PUT-Motorsport/PUTM_EV_AMS_MASTER/documentation/vscode/data/molicelP50B/data/molicelP50B/soc_ocv_curves.png

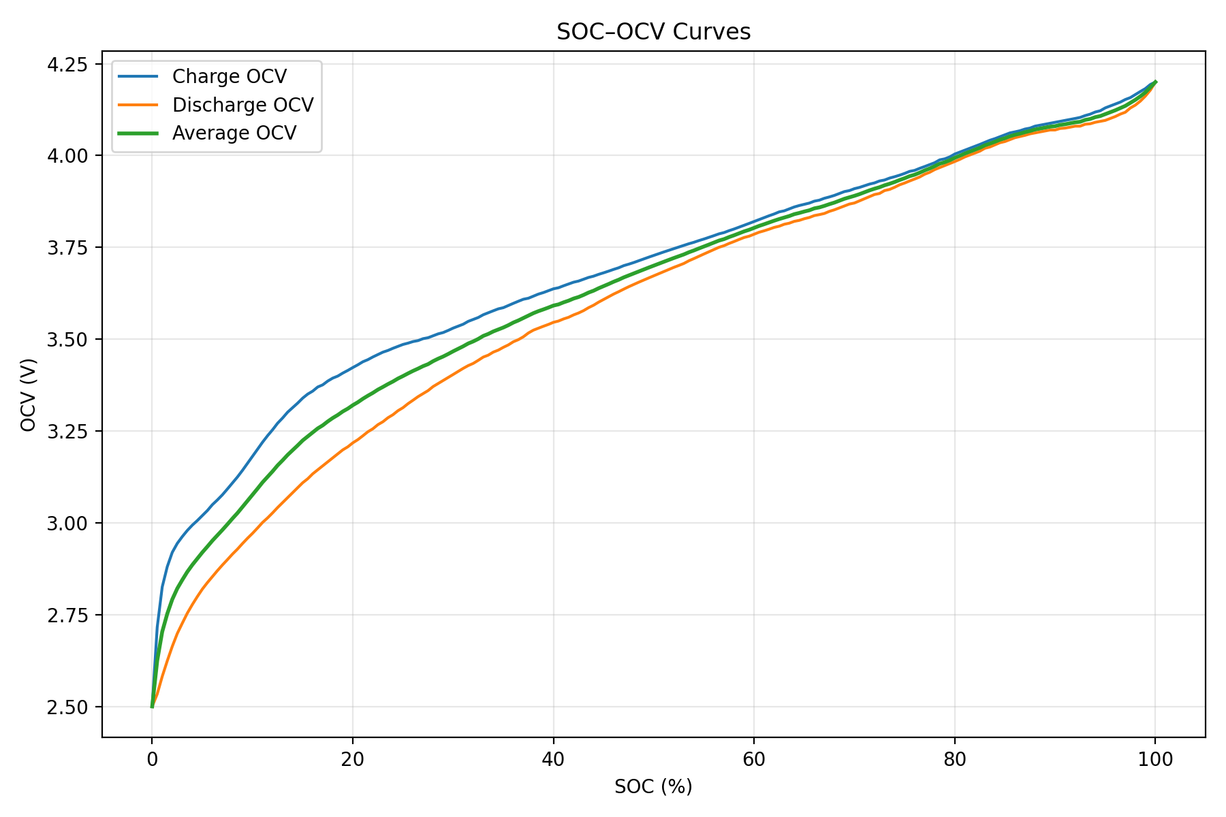
documentation/vscode/data/molicelP50B/data/molicelP50B/soc_ocv_curves.png
