PUT-Motorsport/PUTM_EV_AMS_MASTER/documentation/vscode/python/batemoP50-25C-DCR.png

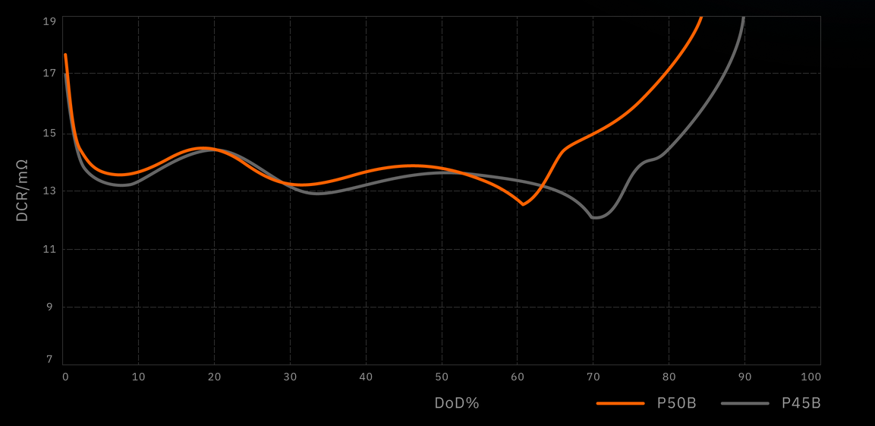
documentation/vscode/python/batemoP50-25C-DCR.png
