PUT-Motorsport/PUTM_EV_AMS_MASTER/documentation/vscode/python/batemoP50-60-DCR.png

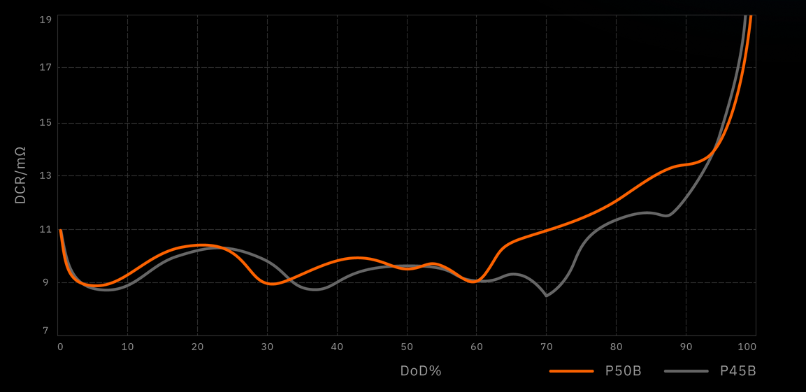
documentation/vscode/python/batemoP50-60-DCR.png
