PUT-Motorsport/PUTM_EV_AMS_MASTER/hardware/AirControl.kicad_sch

## KiCad design hardware/AirControl.kicad_sch (2025-06-25)

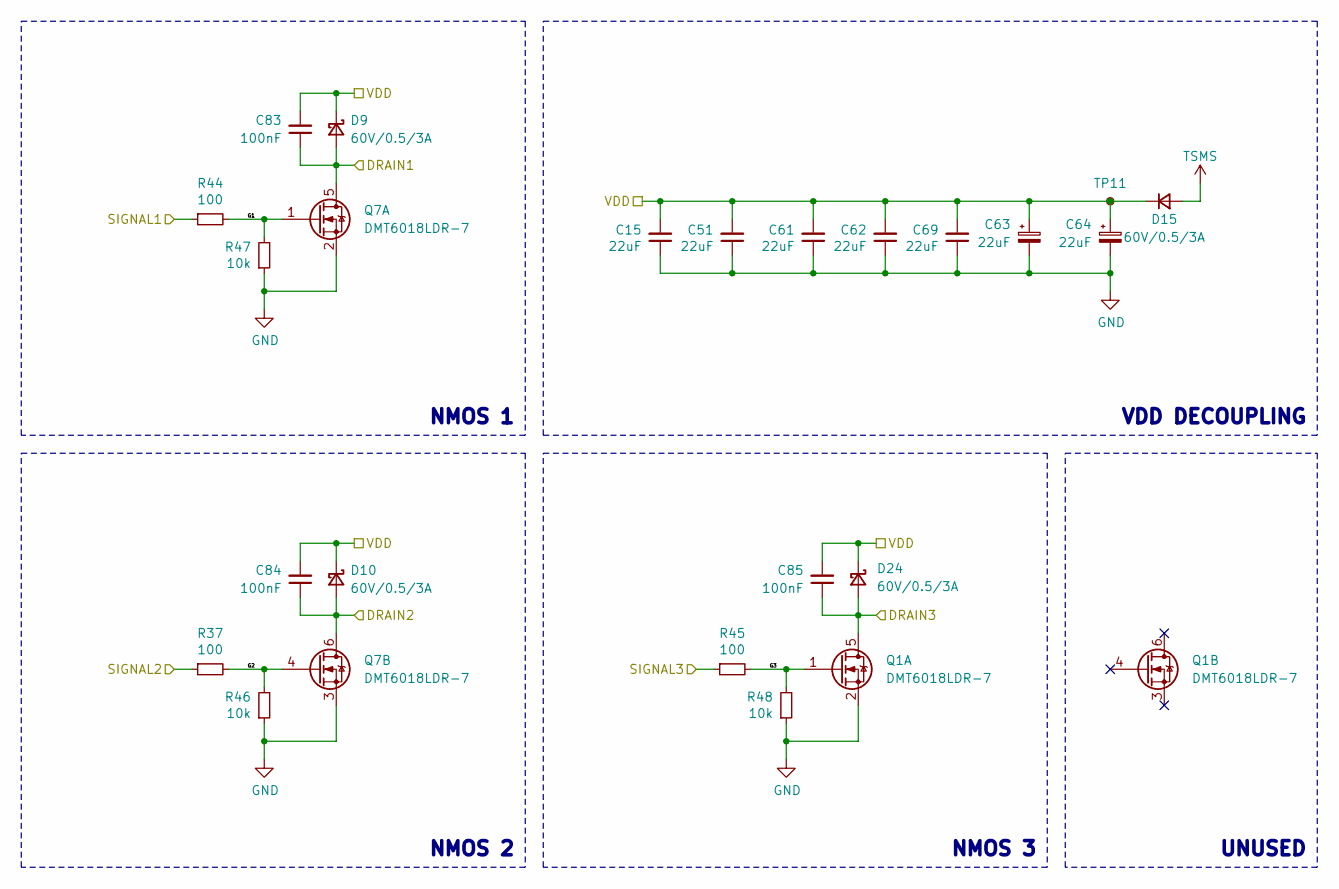
[picture p6: schematic AirControl.kicad_sch]

Parts:
C15, C51, C61, C62, C69: 22uF; C_0805_2012Metric; Manufacturer_Part_Number CL21A107MQYNNWE; Mouser Part Number 810-C2012X5R1V226MAC
C63, C64: 22uF; CP_Elec_4x5.8; Mouser Part Number 647-UCM1V220MCL1GS
C83, C84, C85: 100nF; C_0603_1608Metric; Manufacturer_Part_Number --; Mouser Part Number --
D9, D10, D15, D24: 60V/0.5/3A; D_SOD-123; Mouser Part Number 637-SKL36
Q1, Q7: DMT6018LDR-7; DMT6018LDR7; Mouser Part Number 621-DMT6018LDR-7
R37, R44, R45: 100; R_0603_1608Metric; Manufacturer_Part_Number --; Mouser Part Number --
R46, R47, R48: 10k; R_0603_1608Metric; Manufacturer_Part_Number --; Mouser Part Number --
TP11: TestPoint_Small; TestPoint_THTPad_D1.0mm_Drill0.5mm; Mouser Part Number --

Connections:
DRAIN1: C83.1, D9.2 (A), Q7.5 (D1)
DRAIN2: C84.1, D10.2 (A), Q7.6 (D2)
DRAIN3: C85.1, D24.2 (A), Q1.5 (D1)
G1: Q7.1 (G1), R44.2, R47.2
G2: Q7.4 (G2), R37.2, R46.2
G3: Q1.1 (G1), R45.2, R48.2
GND: C15.1, C51.1, C61.1, C62.1, C63.2, C64.2, C69.1, Q1.2 (S1), Q7.2 (S1), Q7.3 (S2), R46.1, R47.1, R48.1
SIGNAL1: R44.1
SIGNAL2: R37.1
SIGNAL3: R45.1
TSMS: D15.2 (A)
VDD: C15.2, C51.2, C61.2, C62.2, C63.1, C64.1, C69.2, C83.2, C84.2, C85.2, D9.1 (K), D10.1 (K), D15.1 (K), D24.1 (K), TP11.1

Notes on the sheet:
UNUSED
NMOS 1
VDD DECOUPLING
NMOS 2
NMOS 3
