PUT-Motorsport/PUTM_EV_AMS_MASTER/hardware/Connectivity.kicad_sch

## KiCad design hardware/Connectivity.kicad_sch (2025-06-25)

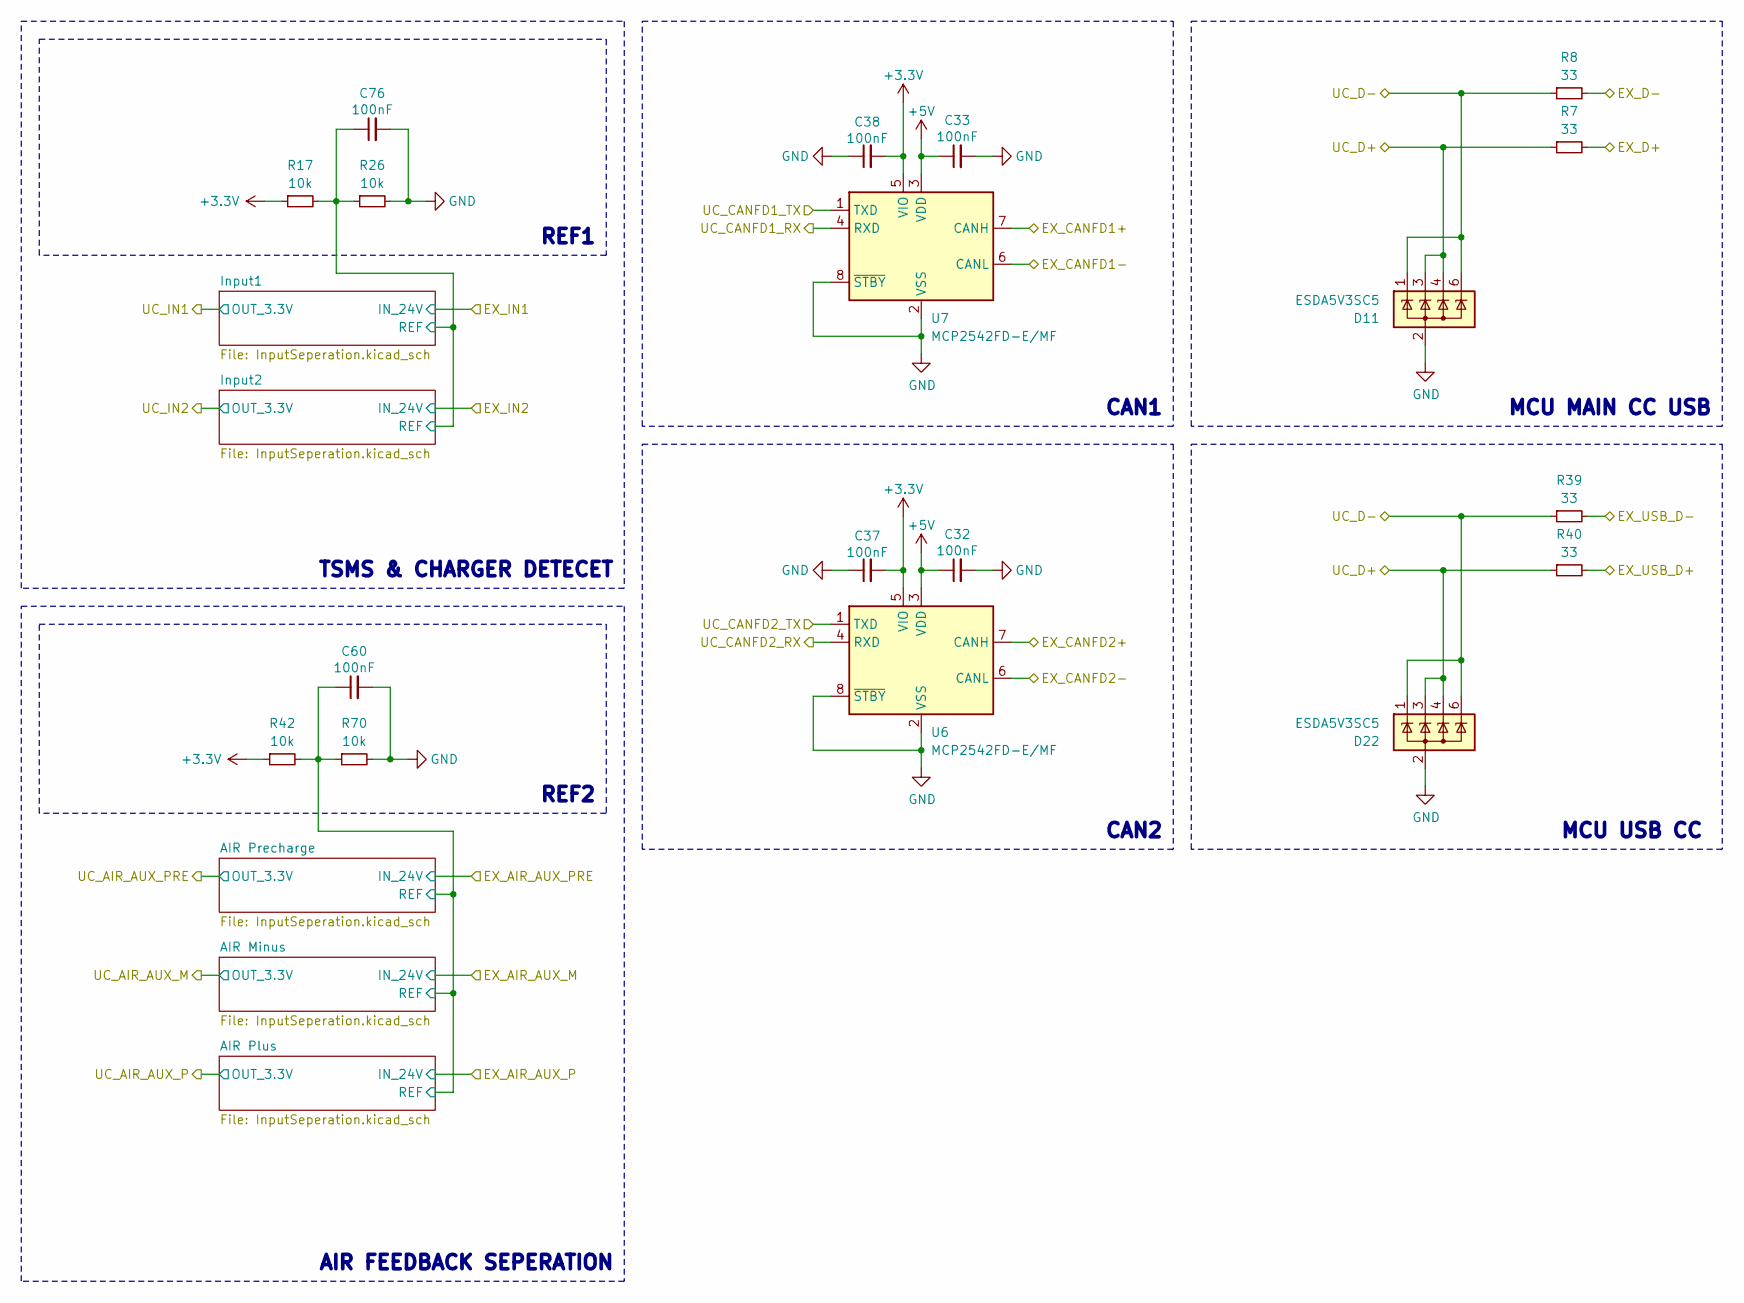
[picture p7: schematic Connectivity.kicad_sch]

Parts:
C32, C33, C37, C38, C60, C76: 100nF; C_0603_1608Metric; Manufacturer_Part_Number --; Mouser Part Number --
D11, D22: ESDA5V3SC5; SOT-23-6; Manufacturer_Part_Number ESDA5V3SC5; Mouser Part Number 511-ESDA5V3SC5
R7, R8, R39, R40: 33; R_0603_1608Metric; Manufacturer_Part_Number --; Mouser Part Number 71-CRCW060333R0FKEC
R17, R26, R42, R70: 10k; R_0603_1608Metric; Manufacturer_Part_Number --; Mouser Part Number --
U6, U7: MCP2542FD-E/MF; DFN-8-1EP_3x3mm_P0.65mm_EP1.55x2.4mm; Manufacturer_Part_Number MCP2542FD-E/MF; Mouser Part Number 579-MCP2542FD-E/MF

Connections:
+3.3V: C37.2, C38.2, R17.1, R42.1, U6.5 (VIO), U7.5 (VIO)
+5V: C32.1, C33.1, U6.3 (VDD), U7.3 (VDD)
EX_CANFD1+: U7.7 (CANH)
EX_CANFD1-: U7.6 (CANL)
EX_CANFD2+: U6.7 (CANH)
EX_CANFD2-: U6.6 (CANL)
EX_D+: R7.2
EX_D-: R8.2
EX_USB_D+: R40.2
EX_USB_D-: R39.2
GND: C32.2, C33.2, C37.1, C38.1, C60.2, C76.2, D11.2 (K), D11.5 (NC), D22.2 (K), D22.5 (NC), R26.2, R70.2, U6.2 (VSS), U6.8 (~STBY), U6.9 (VSS), U7.2 (VSS), U7.8 (~STBY), U7.9 (VSS)
REF: C60.1, C76.1, R17.2, R26.1, R42.2, R70.1
UC_CANFD1_RX: U7.4 (RXD)
UC_CANFD1_TX: U7.1 (TXD)
UC_CANFD2_RX: U6.4 (RXD)
UC_CANFD2_TX: U6.1 (TXD)
UC_D+: D11.3 (A), D11.4 (A), D22.3 (A), D22.4 (A), R7.1, R40.1
UC_D-: D11.1 (A), D11.6 (A), D22.1 (A), D22.6 (A), R8.1, R39.1

Notes on the sheet:
MCU MAIN CC USB
TSMS & CHARGER DETECET
CAN1
REF2
AIR FEEDBACK SEPERATION
REF1
CAN2
MCU USB CC
