PUT-Motorsport/PUTM_EV_AMS_MASTER/hardware/FanControl.kicad_sch

## KiCad design hardware/FanControl.kicad_sch (2025-06-25)

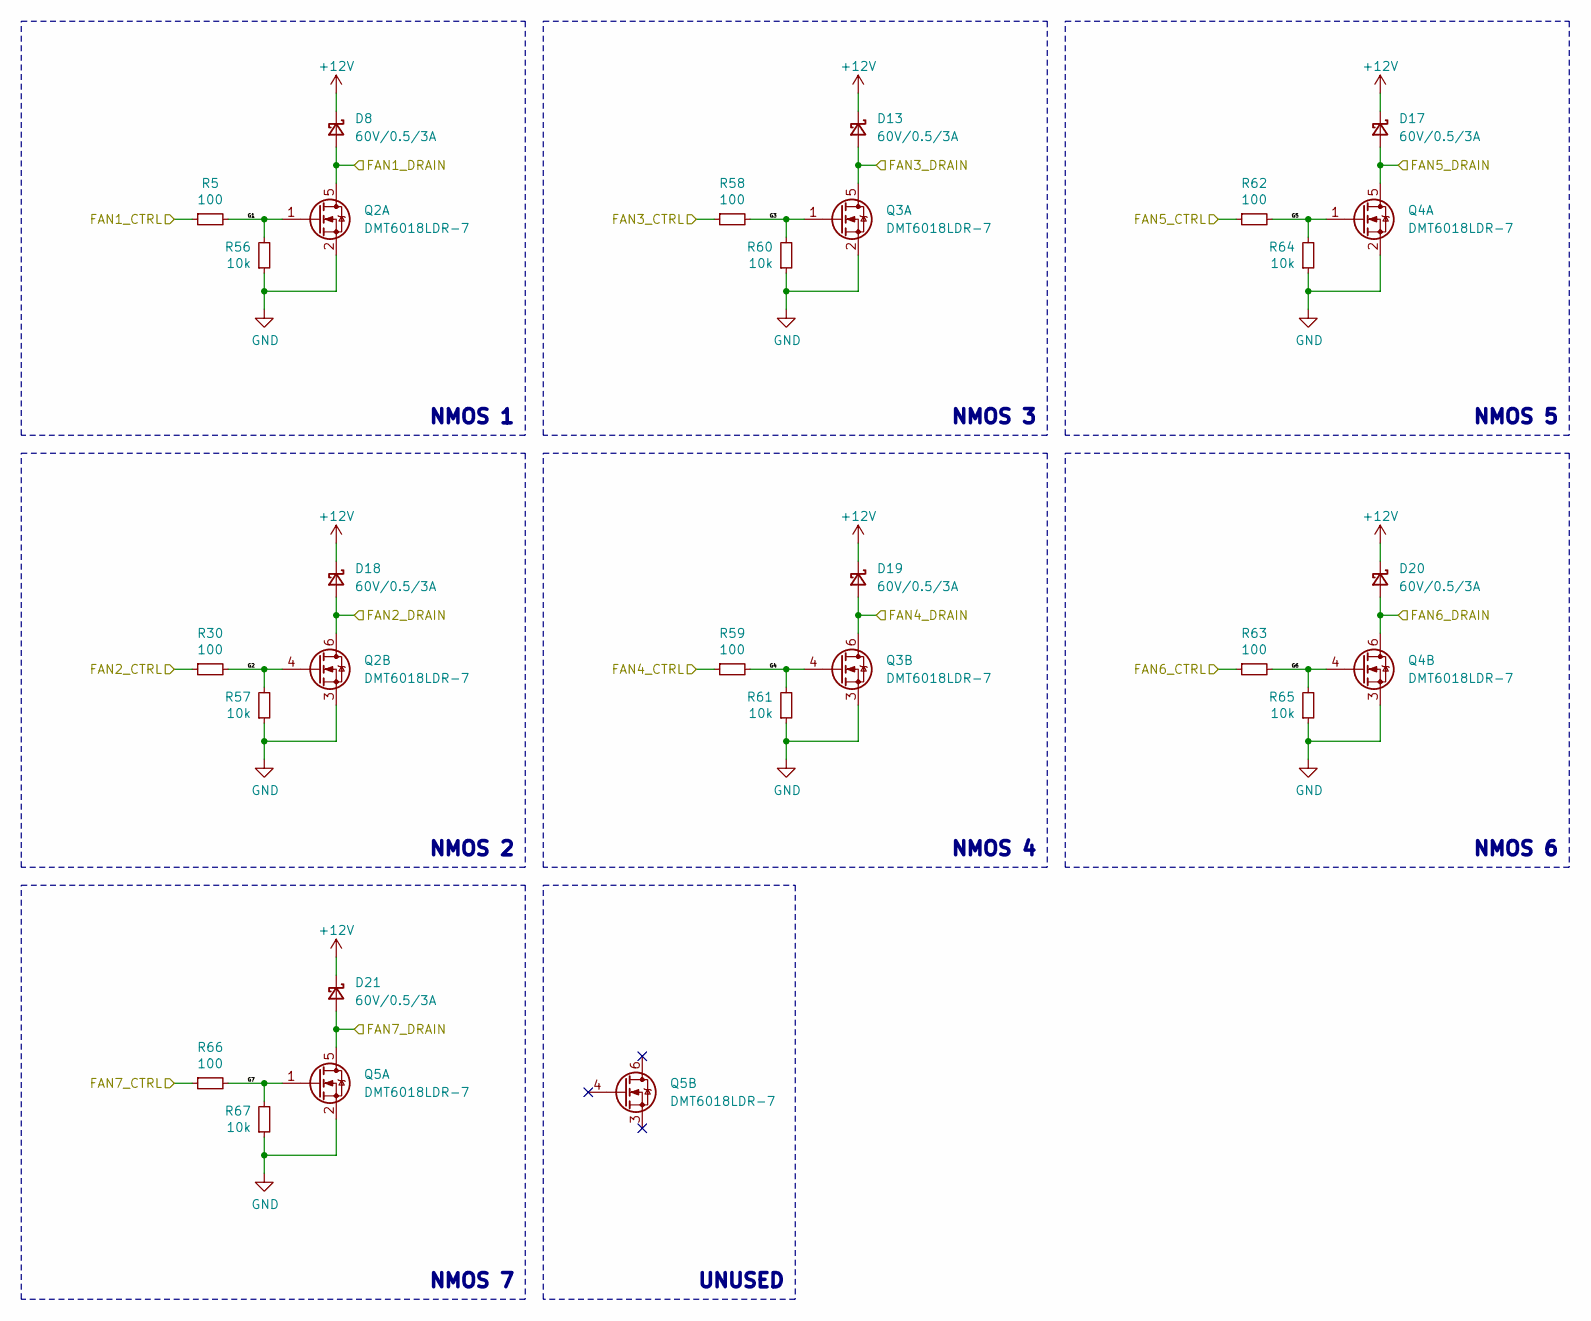
[picture p8: schematic FanControl.kicad_sch]

Parts:
D8, D13, D17, D18, D19, D20, D21: 60V/0.5/3A; D_SOD-123; Mouser Part Number 637-SKL36
Q2, Q3, Q4, Q5: DMT6018LDR-7; DMT6018LDR7; Mouser Part Number 621-DMT6018LDR-7
R5, R30, R58, R59, R62, R63, R66: 100; R_0603_1608Metric; Manufacturer_Part_Number --; Mouser Part Number --
R56, R57, R60, R61, R64, R65, R67: 10k; R_0603_1608Metric; Manufacturer_Part_Number --; Mouser Part Number --

Connections:
+12V: D8.1 (K), D13.1 (K), D17.1 (K), D18.1 (K), D19.1 (K), D20.1 (K), D21.1 (K)
FAN1_CTRL: R5.1
FAN1_DRAIN: D8.2 (A), Q2.5 (D1)
FAN2_CTRL: R30.1
FAN2_DRAIN: D18.2 (A), Q2.6 (D2)
FAN3_CTRL: R58.1
FAN3_DRAIN: D13.2 (A), Q3.5 (D1)
FAN4_CTRL: R59.1
FAN4_DRAIN: D19.2 (A), Q3.6 (D2)
FAN5_CTRL: R62.1
FAN5_DRAIN: D17.2 (A), Q4.5 (D1)
FAN6_CTRL: R63.1
FAN6_DRAIN: D20.2 (A), Q4.6 (D2)
FAN7_CTRL: R66.1
FAN7_DRAIN: D21.2 (A), Q5.5 (D1)
G1: Q2.1 (G1), R5.2, R56.2
G2: Q2.4 (G2), R30.2, R57.2
G3: Q3.1 (G1), R58.2, R60.2
G4: Q3.4 (G2), R59.2, R61.2
G5: Q4.1 (G1), R62.2, R64.2
G6: Q4.4 (G2), R63.2, R65.2
G7: Q5.1 (G1), R66.2, R67.2
GND: Q2.2 (S1), Q2.3 (S2), Q3.2 (S1), Q3.3 (S2), Q4.2 (S1), Q4.3 (S2), Q5.2 (S1), R56.1, R57.1, R60.1, R61.1, R64.1, R65.1, R67.1

Notes on the sheet:
NMOS 2
NMOS 1
NMOS 4
UNUSED
NMOS 6
NMOS 3
NMOS 5
NMOS 7
