PUT-Motorsport/PUTM_EV_AMS_MASTER/hardware/InputSeperation.kicad_sch

## KiCad design hardware/InputSeperation.kicad_sch (2025-06-25)

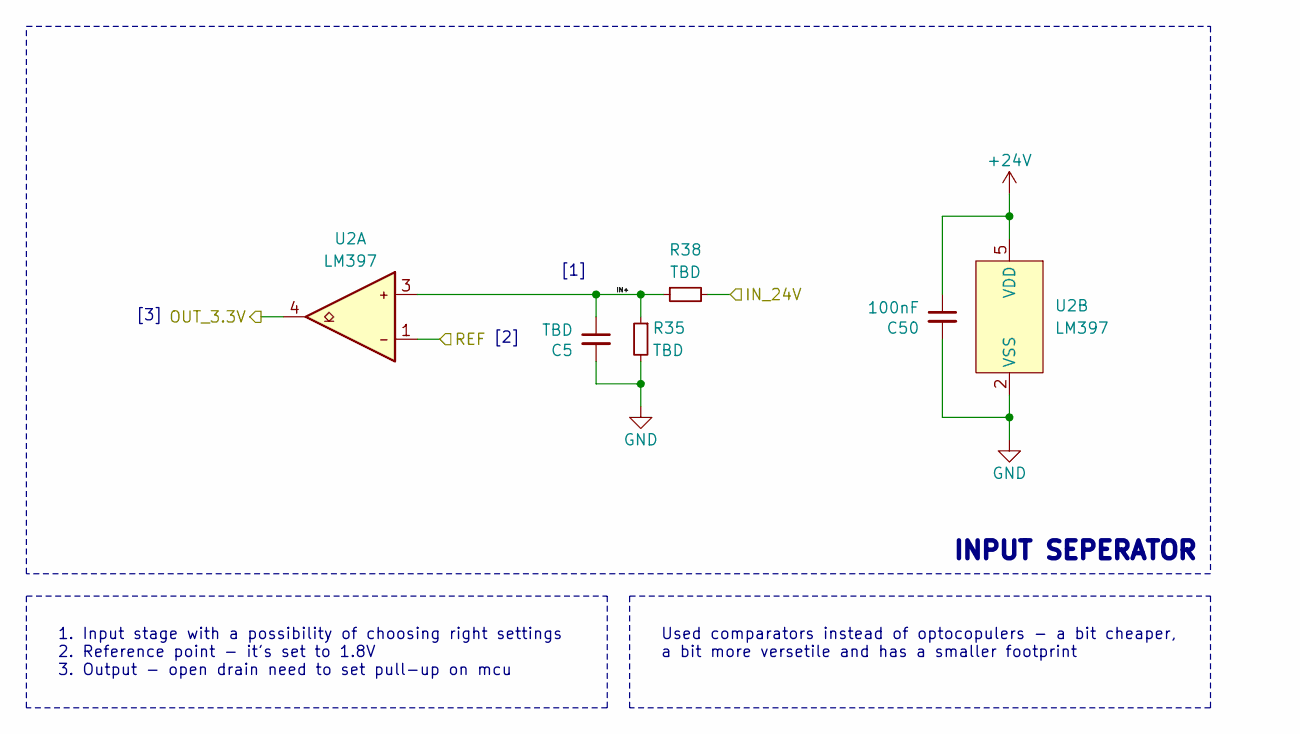
[picture p9: schematic InputSeperation.kicad_sch]

Parts:
C5: TBD; C_0603_1608Metric; Manufacturer_Part_Number --; Mouser Part Number --
C50: 100nF; C_0603_1608Metric; Manufacturer_Part_Number --; Mouser Part Number --
R35, R38: TBD; R_0603_1608Metric; Manufacturer_Part_Number --; Mouser Part Number --
U2: LM397; SOT-23-5; Manufacturer_Part_Number LM397MFX/NOPB; Mouser Part Number 926-LM397MFX/NOPB

Connections:
+24V: C50.1, U2.5 (VDD)
GND: C5.2, C50.2, R35.2, U2.2 (VSS)
IN+: C5.1, R35.1, R38.1, U2.3
IN_24V: R38.2
OUT_3.3V: U2.4
REF: U2.1

Notes on the sheet:
[2]
[3]
INPUT SEPERATOR
[1]
Used comparators instead of optocopulers - a bit cheaper, a bit more versetile and has a smaller footprint
1. Input stage with a possibility of choosing right settings 2. Reference point - it's set to 1.8V 3. Output - open drain need to set pull-up on mcu
