PUT-Motorsport/PUTM_EV_AMS_MASTER/hardware/IsolatedADC.kicad_sch

## KiCad design hardware/IsolatedADC.kicad_sch (2025-06-25)

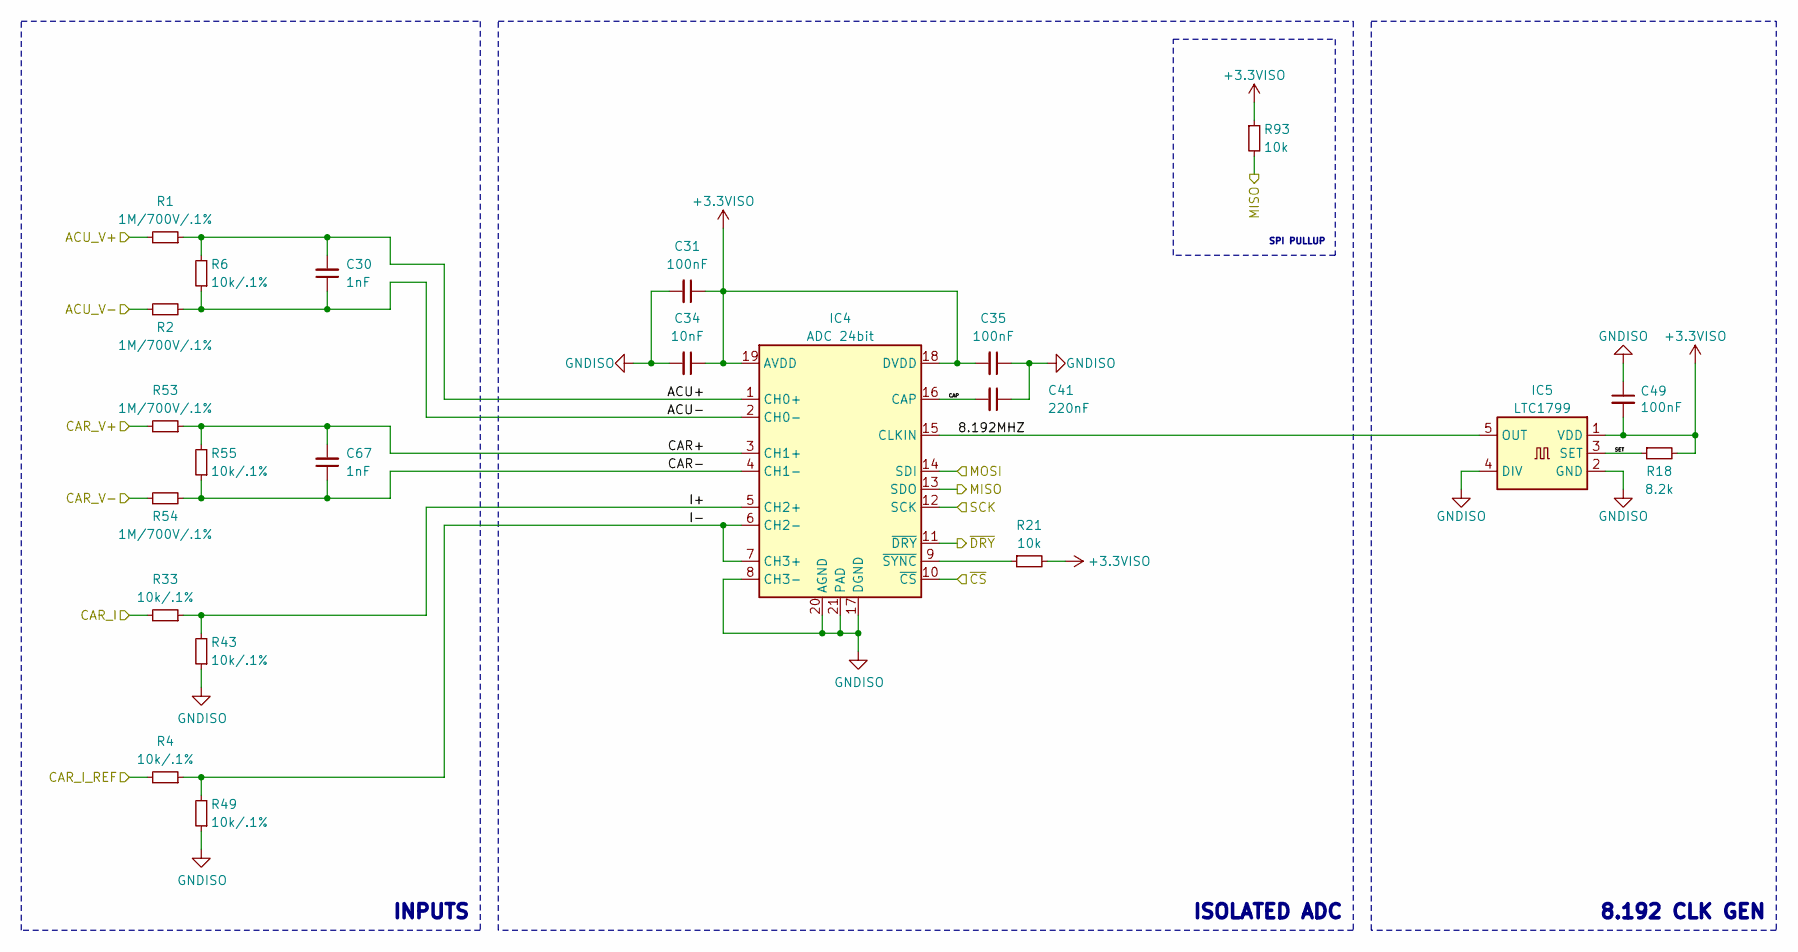
[picture p10: schematic IsolatedADC.kicad_sch]

Parts:
C30, C67: 1nF; C_0603_1608Metric; Manufacturer_Part_Number --; Mouser Part Number --
C31, C35, C49: 100nF; C_0603_1608Metric; Manufacturer_Part_Number --; Mouser Part Number --
C34: 10nF; C_0603_1608Metric; Manufacturer_Part_Number --; Mouser Part Number --
C41: 220nF; C_0603_1608Metric; Manufacturer_Part_Number --; Mouser Part Number 963-H168SC7224KTCA1J
IC4: ADC 24bit; WQFN-20-1EP_3x3mm_P0.4mm_EP1.7x1.7mm; Mouser Part Number 595-ADS131M04IRUKR
IC5: LTC1799; SOT-23-5; Mouser Part Number 584-LTC1799CS5#TRPBF
R1, R2, R53, R54: 1M/700V/.1%; R_1206_3216Metric; Manufacturer_Part_Number 754-RGV3216P-1004BT1; Mouser Part Number 754-RGV3216P-1004BT1
R4, R33: 10k/.1%; R_0603_1608Metric; Manufacturer_Part_Number --; Mouser Part Number --
R6, R43, R49, R55: 10k/.1%; R_1206_3216Metric; Manufacturer_Part_Number --; Mouser Part Number 708-RNCF1206BKE100R
R18: 8.2k; R_0603_1608Metric; Manufacturer_Part_Number --; Mouser Part Number 603-RT0603FRD078K2L
R21, R93: 10k; R_0603_1608Metric; Manufacturer_Part_Number --; Mouser Part Number --

Connections:
8.192MHZ: IC4.15 (CLKIN), IC5.5 (OUT)
+3.3VISO: C31.1, C34.1, C35.2, C49.2, IC4.18 (DVDD), IC4.19 (AVDD), IC5.1 (VDD), R18.2, R21.2, R93.1
ACU+: C30.2, IC4.1 (CH0+), R1.1, R6.2
ACU-: C30.1, IC4.2 (CH0-), R2.2, R6.1
ACU_V+: R1.2
ACU_V-: R2.1
CAP: C41.2, IC4.16 (CAP)
CAR+: C67.2, IC4.3 (CH1+), R53.1, R55.2
CAR-: C67.1, IC4.4 (CH1-), R54.2, R55.1
CAR_I: R33.2
CAR_I_REF: R4.2
CAR_V+: R53.2
CAR_V-: R54.1
GNDISO: C31.2, C34.2, C35.1, C41.1, C49.1, IC4.8 (CH3-), IC4.17 (DGND), IC4.20 (AGND), IC4.21 (PAD), IC5.2 (GND), IC5.4 (DIV), R43.1, R49.1
I+: IC4.5 (CH2+), R33.1, R43.2
I-: IC4.6 (CH2-), IC4.7 (CH3+), R4.1, R49.2
MISO: IC4.13 (SDO), R93.2
MOSI: IC4.14 (SDI)
unnamed: IC4.9 (~SYNC), R21.1
SCK: IC4.12 (SCK)
SET: IC5.3 (SET), R18.1
~CS: IC4.10 (~CS)
~DRY: IC4.11 (~DRY)

Notes on the sheet:
SPI PULLUP
INPUTS
8.192 CLK GEN
ISOLATED ADC
