PUT-Motorsport/PUTM_EV_AMS_MASTER/hardware/IsolatedSPI.kicad_sch

## KiCad design hardware/IsolatedSPI.kicad_sch (2025-06-25)

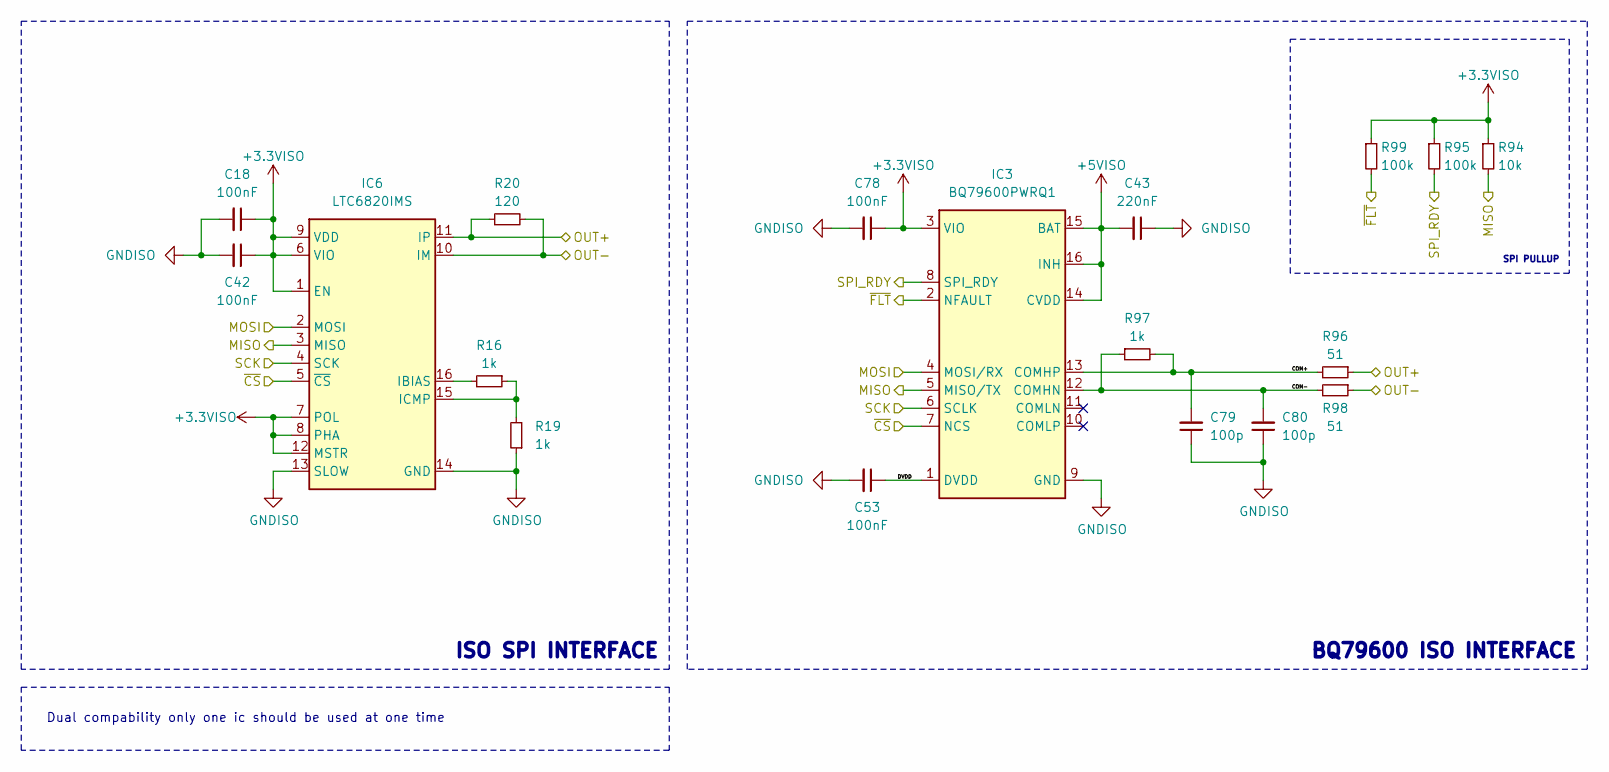
[picture p11: schematic IsolatedSPI.kicad_sch]

Parts:
C18, C42, C53, C78: 100nF; C_0603_1608Metric; Manufacturer_Part_Number --; Mouser Part Number --
C43: 220nF; C_0603_1608Metric; Manufacturer_Part_Number --; Mouser Part Number 963-H168SC7224KTCA1J
C79, C80: 100p; C_0603_1608Metric; Manufacturer_Part_Number --; Mouser Part Number 581-06035A101K
IC3: BQ79600PWRQ1; TSSOP-16_4.4x5mm_P0.65mm; Mouser Part Number 595-BQ79600PWRQ1
IC6: LTC6820IMS; MSOP-16_3x4.039mm_P0.5mm; Mouser Part Number 584-LTC6820IMS#PBF
R16, R19, R97: 1k; R_0603_1608Metric; Manufacturer_Part_Number --; Mouser Part Number --
R20: 120; R_0603_1608Metric; Manufacturer_Part_Number --; Mouser Part Number --
R94: 10k; R_0603_1608Metric; Manufacturer_Part_Number --; Mouser Part Number --
R95, R99: 100k; R_0603_1608Metric; Manufacturer_Part_Number --; Mouser Part Number --
R96, R98: 51; R_0603_1608Metric; Manufacturer_Part_Number --; Mouser Part Number 594-MCT06030C5109FP5

Connections:
+3.3VISO: C18.1, C42.1, C78.1, IC3.3 (VIO), IC6.1 (EN), IC6.6 (VIO), IC6.7 (POL), IC6.8 (PHA), IC6.9 (VDD), IC6.12 (MSTR), R94.1, R95.1, R99.1
+5VISO: C43.2, IC3.14 (CVDD), IC3.15 (BAT), IC3.16 (INH)
COM+: C79.2, IC3.13 (COMHP), R96.2, R97.2
COM-: C80.2, IC3.12 (COMHN), R97.1, R98.2
DVDD: C53.1, IC3.1 (DVDD)
GNDISO: C18.2, C42.2, C43.1, C53.2, C78.2, C79.1, C80.1, IC3.9 (GND), IC6.13 (SLOW), IC6.14 (GND), R19.1
MISO: IC3.5 (MISO/TX), IC6.3 (MISO), R94.2
MOSI: IC3.4 (MOSI/RX), IC6.2 (MOSI)
unnamed: IC6.15 (ICMP), R16.1, R19.2
unnamed: IC6.16 (IBIAS), R16.2
OUT+: IC6.11 (IP), R20.1, R96.1
OUT-: IC6.10 (IM), R20.2, R98.1
SCK: IC3.6 (SCLK), IC6.4 (SCK)
SPI_RDY: IC3.8 (SPI_RDY), R95.2
~CS: IC3.7 (NCS), IC6.5 (~CS)
~FLT: IC3.2 (NFAULT), R99.2

Notes on the sheet:
ISO SPI INTERFACE
SPI PULLUP
BQ79600 ISO INTERFACE
Dual compability only one ic should be used at one time
