PUT-Motorsport/PUTM_EV_AMS_MASTER/hardware/Mcu.kicad_sch

## KiCad design hardware/Mcu.kicad_sch (2025-06-25)

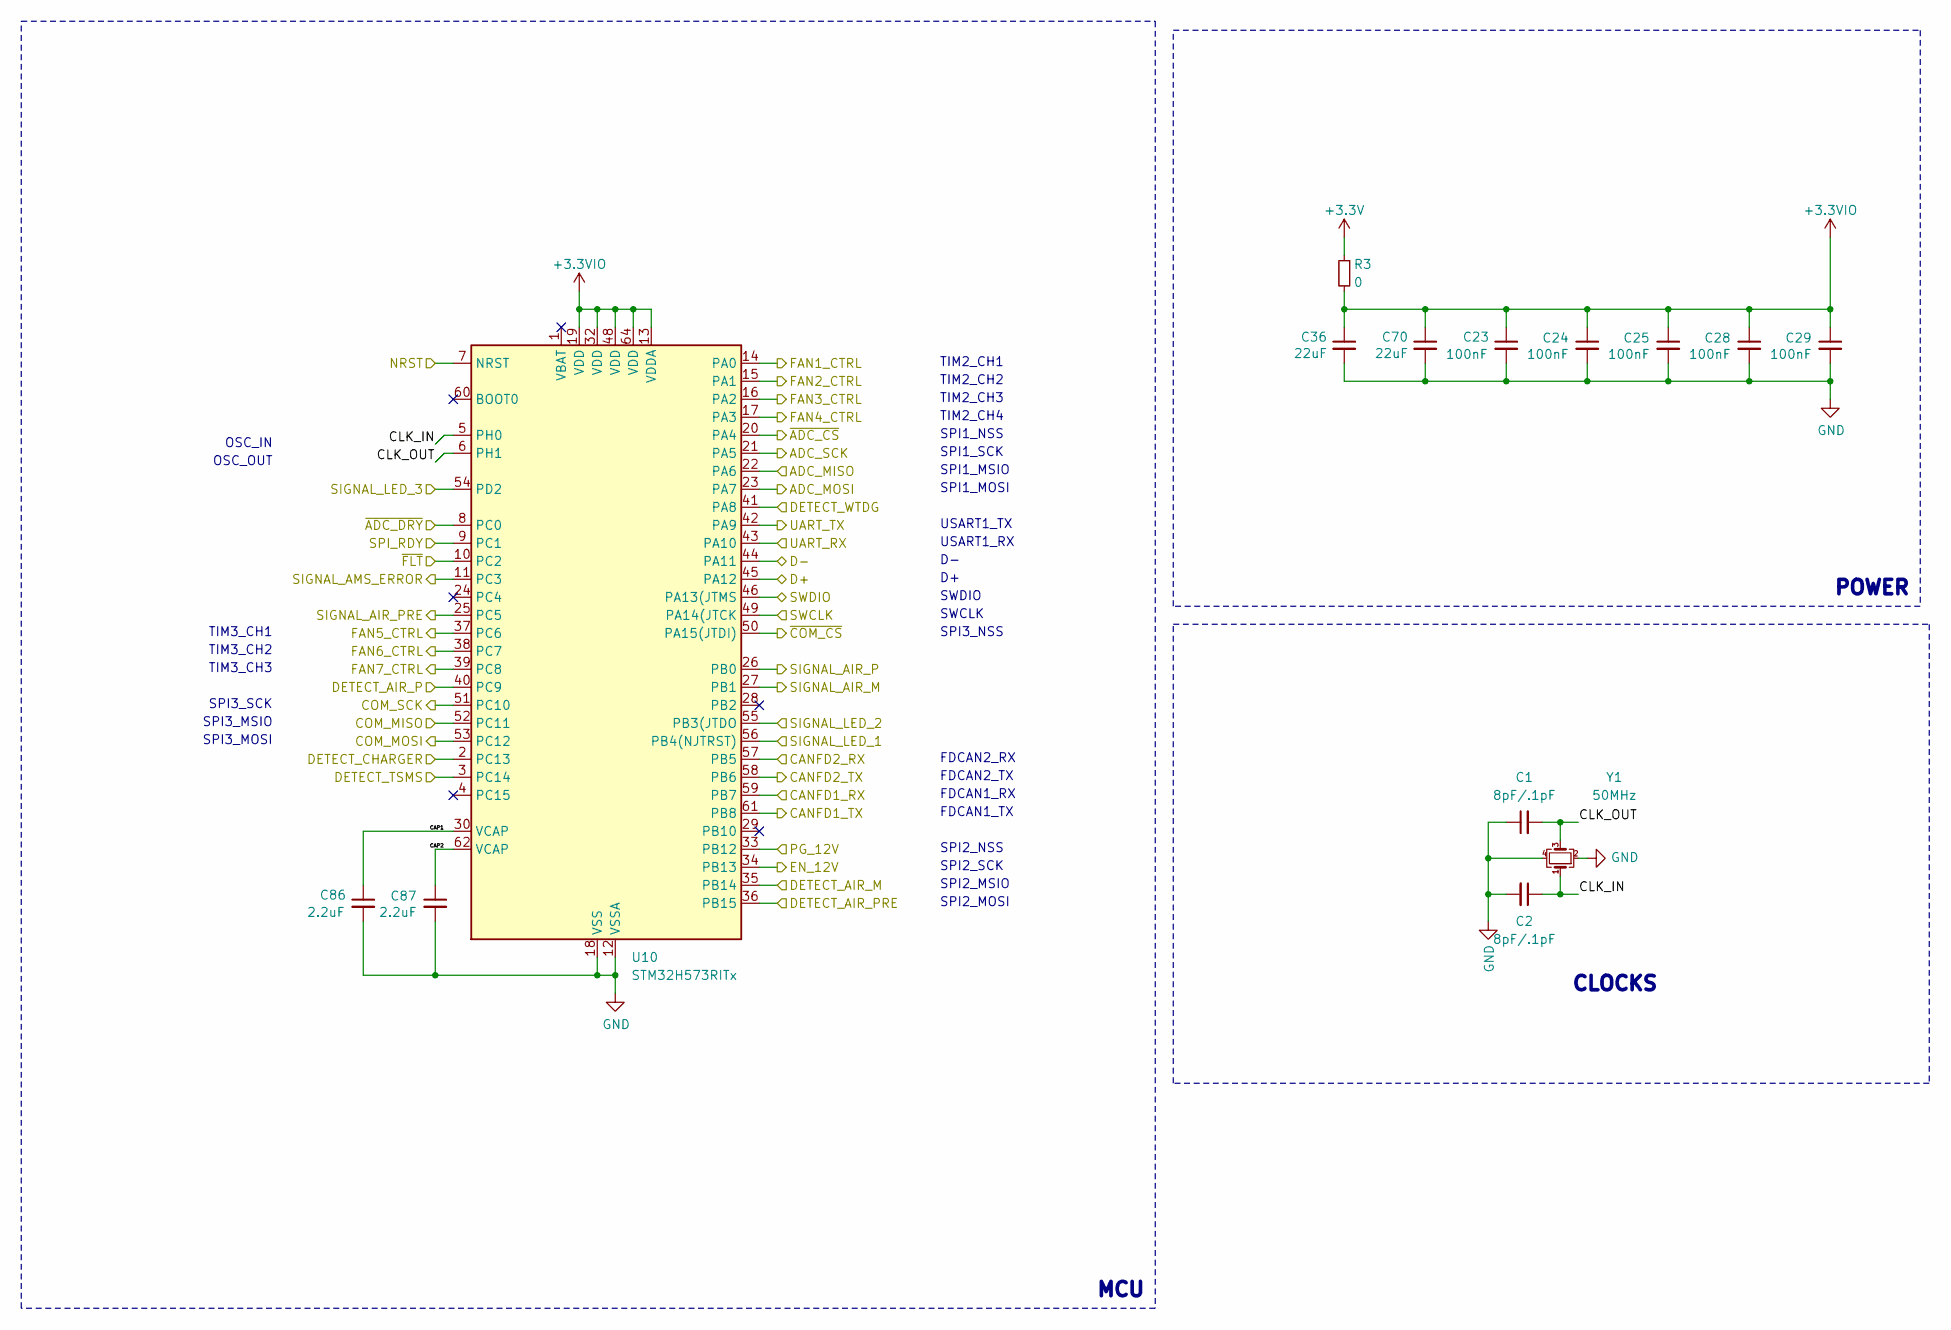
[picture p12: schematic Mcu.kicad_sch]

Parts:
C1, C2: 8pF/.1pF; C_0603_1608Metric; Manufacturer_Part_Number --; Mouser Part Number 791-RF18N8R0B500CT
C23, C24, C25, C28, C29: 100nF; C_0603_1608Metric; Manufacturer_Part_Number --; Mouser Part Number --
C36, C70: 22uF; C_0805_2012Metric; Manufacturer_Part_Number --; Mouser Part Number 810-C2012X5R1V226MAC
C86, C87: 2.2uF; C_0603_1608Metric; Manufacturer_Part_Number --; Mouser Part Number 603-CC603KPX7R9BB222
R3: 0; R_0603_1608Metric; Manufacturer_Part_Number --; Mouser Part Number --
U10: STM32H573RITx; LQFP-64_10x10mm_P0.5mm; Mouser Part Number 511-STM32H573RIT6
Y1: 50MHz; Crystal_SMD_3225-4Pin_3.2x2.5mm; Manufacturer_Part_Number --; Mouser Part Number 710-830108207809

Connections:
+3.3V: R3.1
+3.3VIO: C23.1, C24.1, C25.1, C28.1, C29.1, C36.1, C70.1, R3.2, U10.13 (VDDA), U10.19 (VDD), U10.32 (VDD), U10.48 (VDD), U10.64 (VDD)
ADC_MISO: U10.22 (PA6)
ADC_MOSI: U10.23 (PA7)
ADC_SCK: U10.21 (PA5)
CANFD1_RX: U10.59 (PB7)
CANFD1_TX: U10.61 (PB8)
CANFD2_RX: U10.57 (PB5)
CANFD2_TX: U10.58 (PB6)
CAP1: C86.1, U10.30 (VCAP)
CAP2: C87.1, U10.62 (VCAP)
CLK_IN: C2.1, U10.5 (PH0), Y1.1
CLK_OUT: C1.2, U10.6 (PH1), Y1.3
COM_MISO: U10.52 (PC11)
COM_MOSI: U10.53 (PC12)
COM_SCK: U10.51 (PC10)
D+: U10.45 (PA12)
D-: U10.44 (PA11)
DETECT_AIR_M: U10.35 (PB14)
DETECT_AIR_P: U10.40 (PC9)
DETECT_AIR_PRE: U10.36 (PB15)
DETECT_CHARGER: U10.2 (PC13)
DETECT_TSMS: U10.3 (PC14)
DETECT_WTDG: U10.41 (PA8)
EN_12V: U10.34 (PB13)
FAN1_CTRL: U10.14 (PA0)
FAN2_CTRL: U10.15 (PA1)
FAN3_CTRL: U10.16 (PA2)
FAN4_CTRL: U10.17 (PA3)
FAN5_CTRL: U10.37 (PC6)
FAN6_CTRL: U10.38 (PC7)
FAN7_CTRL: U10.39 (PC8)
GND: C1.1, C2.2, C23.2, C24.2, C25.2, C28.2, C29.2, C36.2, C70.2, C86.2, C87.2, U10.12 (VSSA), U10.18 (VSS), U10.31 (VSS), U10.47 (VSS), U10.63 (VSS), Y1.2, Y1.4
NRST: U10.7 (NRST)
PG_12V: U10.33 (PB12)
SIGNAL_AIR_M: U10.27 (PB1)
SIGNAL_AIR_P: U10.26 (PB0)
SIGNAL_AIR_PRE: U10.25 (PC5)
SIGNAL_AMS_ERROR: U10.11 (PC3)
SIGNAL_LED_1: U10.56 (PB4(NJTRST))
SIGNAL_LED_2: U10.55 (PB3(JTDO)
SIGNAL_LED_3: U10.54 (PD2)
SPI_RDY: U10.9 (PC1)
SWCLK: U10.49 (PA14(JTCK)
SWDIO: U10.46 (PA13(JTMS)
UART_RX: U10.43 (PA10)
UART_TX: U10.42 (PA9)
~ADC_CS: U10.20 (PA4)
~ADC_DRY: U10.8 (PC0)
~COM_CS: U10.50 (PA15(JTDI))
~FLT: U10.10 (PC2)

Notes on the sheet:
MCU
USART1_RX
OSC_IN
USART1_TX
TIM2_CH4
FDCAN2_TX
SPI1_MSIO
TIM2_CH2
SPI3_MOSI
SPI2_SCK
OSC_OUT
FDCAN1_TX
SPI3_MSIO
SPI3_SCK
TIM3_CH2
SPI1_SCK
TIM2_CH3
CLOCKS
SPI3_NSS
SPI1_MOSI
TIM3_CH3
SPI1_NSS
SWDIO
SPI2_MOSI
SWCLK
FDCAN2_RX
SPI2_NSS
SPI2_MSIO
TIM2_CH1
TIM3_CH1
FDCAN1_RX
POWER
