PUT-Motorsport/PUTM_EV_AMS_MASTER/hardware/PUTM_EV_AMS_MASTER_2025.kicad_sch

## KiCad design hardware/PUTM_EV_AMS_MASTER_2025.kicad_sch (2025-06-25)

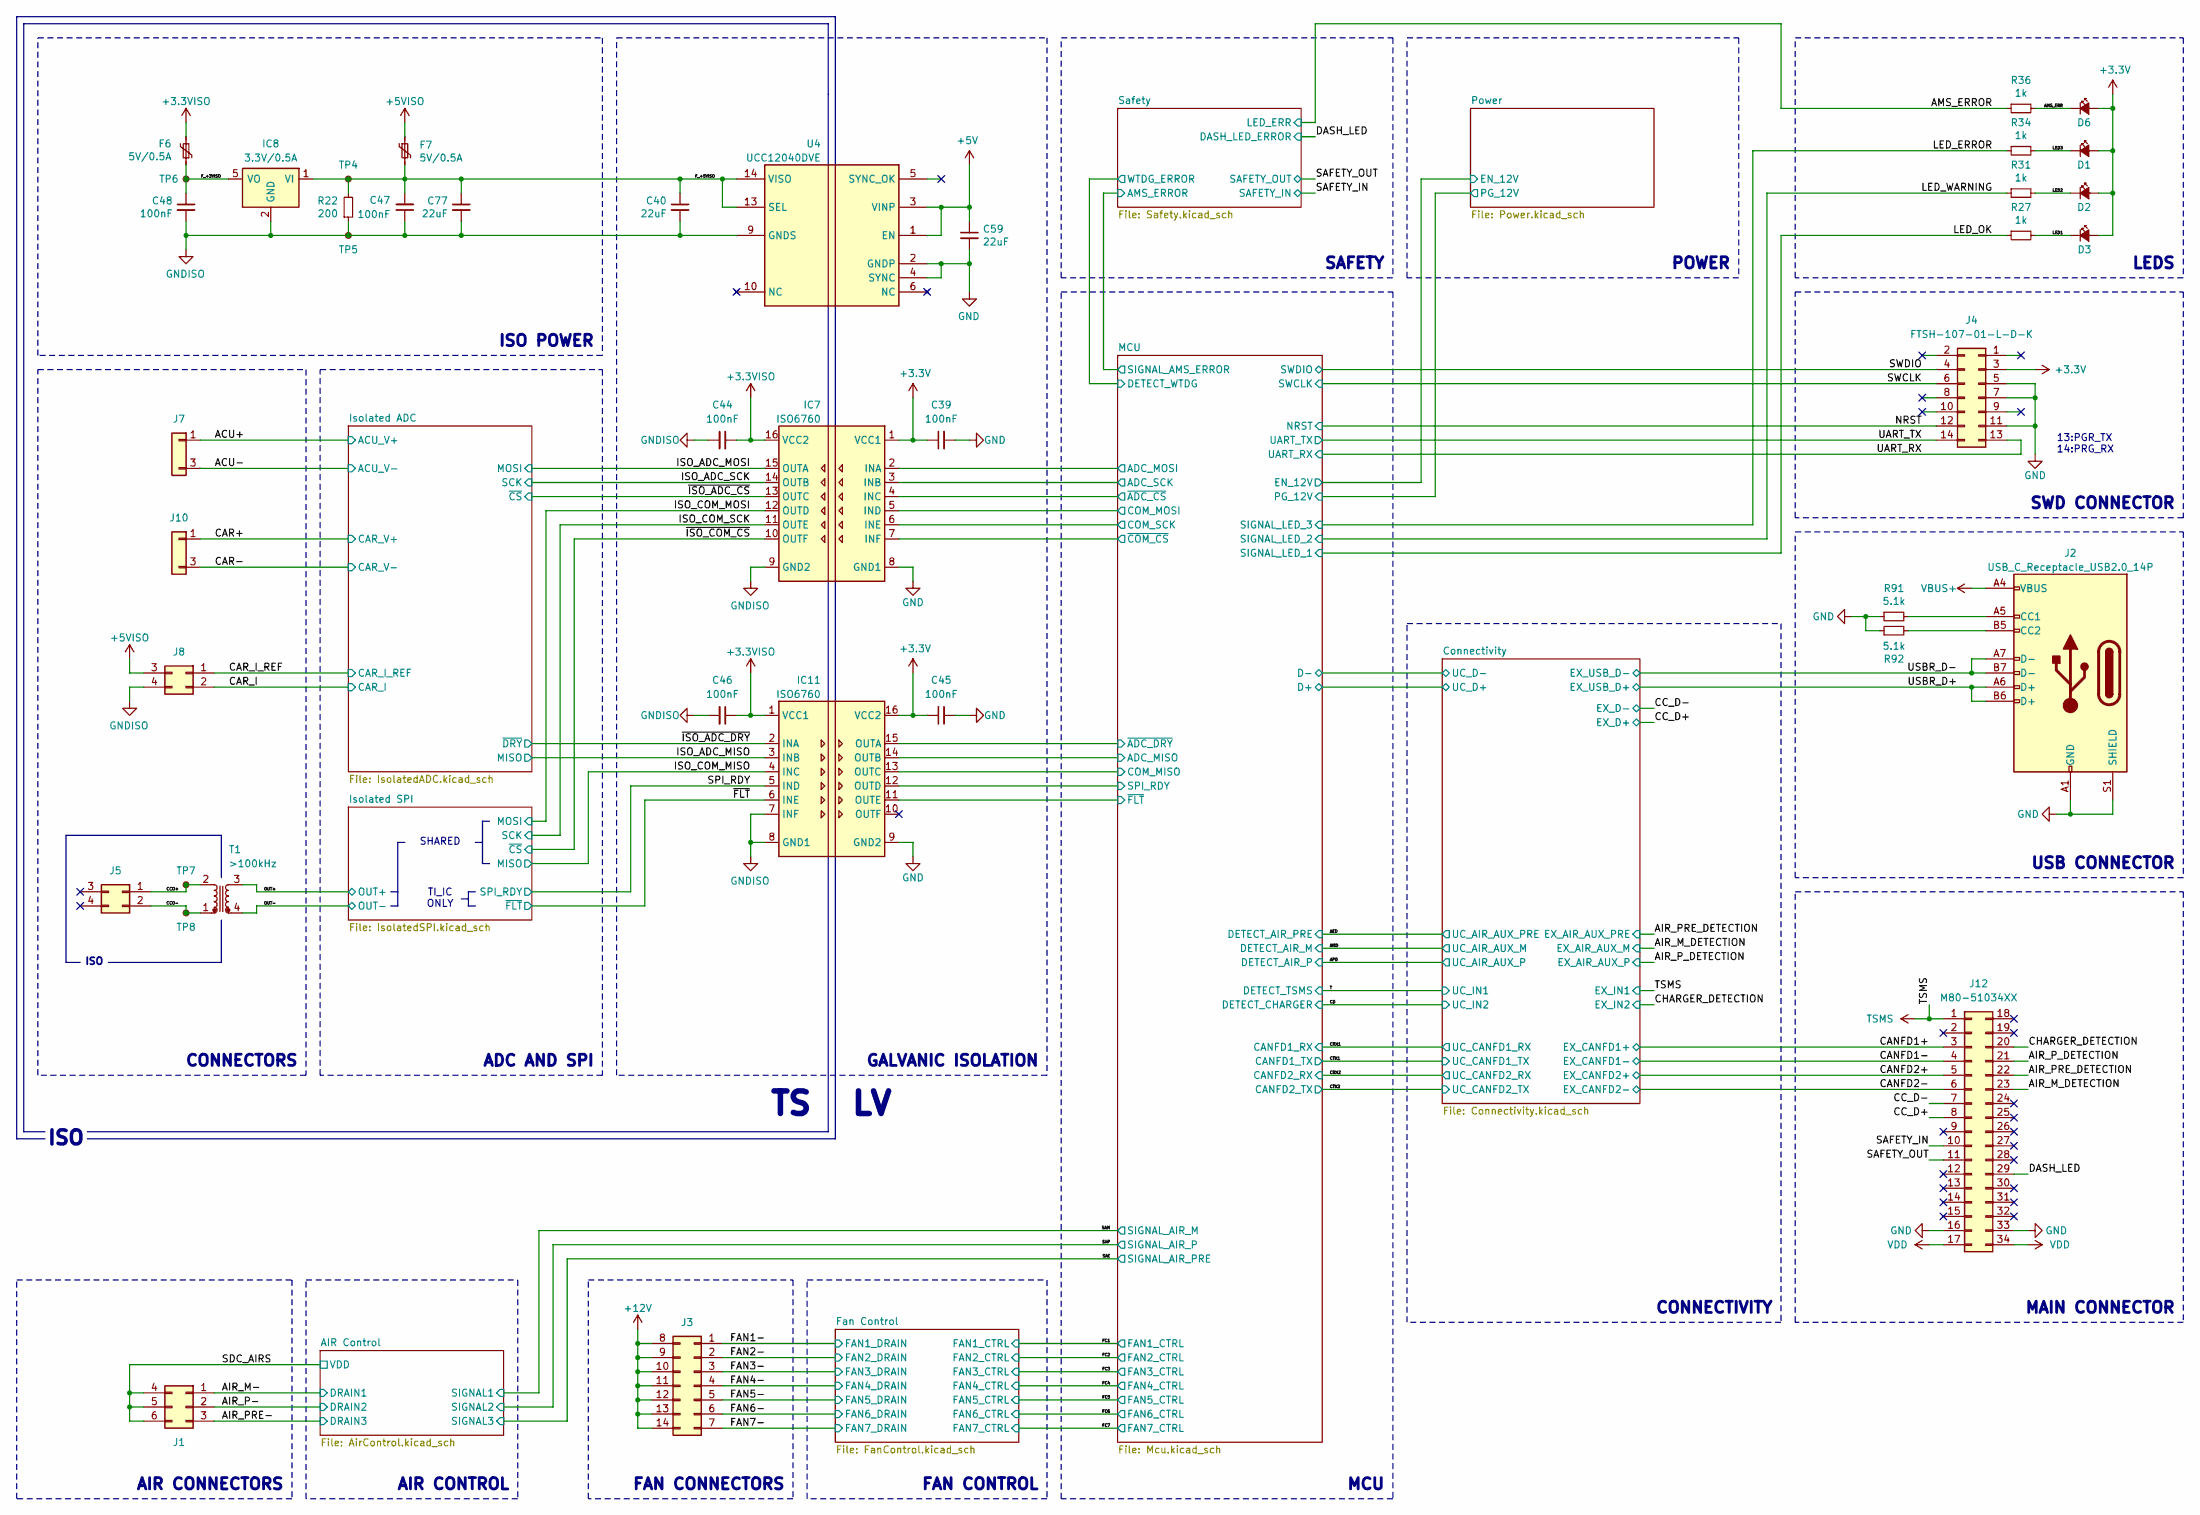
[picture p13: schematic PUTM_EV_AMS_MASTER_2025.kicad_sch]

Parts:
C39, C44, C45, C46, C47, C48: 100nF; C_0603_1608Metric; Manufacturer_Part_Number --; Mouser Part Number --
C40, C59, C77: 22uF; C_0805_2012Metric; Manufacturer_Part_Number --; Mouser Part Number 810-C2012X5R1V226MAC
D1, D2, D3, D6: LED; LED_0603_1608Metric; Manufacturer_Part_Number --; Mouser Part Number --
F6, F7: 5V/0.5A; Fuse_0805_2012Metric; Manufacturer_Part_Number 0ZCH0050FF2G; Mouser Part Number 530-0ZCH0050FF2G
IC7, IC11: ISO6760; SOIC-16W_7.5x10.3mm_P1.27mm; Mouser Part Number 595-ISO6760QDWRQ1
IC8: 3.3V/0.5A; SOT-23-5; Mouser Part Number 595-TPS7B92033DBVR
J1: M80-5100642; M80-51006YY; Mouser Part Number 855-M80-5100622
J2: USB_C_Receptacle_USB2.0_14P; USB_C_Receptacle_JAE_DX07S024WJ3R400; Mouser Part Number 656-DX07S0024WJ3R400
J3: M80-51014XX; M80-51014YY; Mouser Part Number 855-M80-5101422
J4: FTSH-107-01-L-D-K; FTSH-107-XX-YYY-D-K; Mouser Part Number 200-FTSH10701LDK
J5, J8: M80-51004XX; M80-51004YY; Mouser Part Number 855-M80-5100422
J7, J10: M300-MV10345M1; M300MV10345M1; Mouser Part Number 855-M300-MV10345M1
J12: M80-51034XX; M80-51034YY; Mouser Part Number 855-M80-5103422
R22: 200; R_0603_1608Metric; Manufacturer_Part_Number --; Mouser Part Number --
R27, R31, R34, R36: 1k; R_0603_1608Metric; Manufacturer_Part_Number --; Mouser Part Number --
R91, R92: 5.1k; R_0603_1608Metric; Manufacturer_Part_Number --; Mouser Part Number 603-RC0603FR-075K1P
T1: >100kHz; SOP254P914X350-4N; Mouser Part Number --
TP4, TP5, TP6, TP7, TP8: TestPoint_Small; TestPoint_THTPad_D1.0mm_Drill0.5mm; Mouser Part Number --
U4: UCC12040DVE; SOIC-16W_7.5x10.3mm_P1.27mm; Mouser Part Number 595-UCC12040DVE

Connections:
+3.3V: C39.1, C45.1, D1.2 (A), D2.2 (A), D3.2 (A), D6.2 (A), IC7.1 (VCC1), IC11.16 (VCC2), J4.3
+3.3VISO: C44.1, C46.1, F6.2, IC7.16 (VCC2), IC11.1 (VCC1)
+5V: C59.1, U4.1 (EN), U4.3 (VINP)
+5VISO: F7.1, J8.3
+12V: J3.8, J3.9, J3.10, J3.11, J3.12, J3.13, J3.14
ACU+: J7.1
ACU-: J7.3
ADC_MISO: IC11.14 (OUTB)
ADC_MOSI: IC7.2 (INA)
ADC_SCK: IC7.3 (INB)
AIR_M-: J1.1
AIR_M_DETECTION: J12.23
AIR_P-: J1.2
AIR_PRE-: J1.3
AIR_PRE_DETECTION: J12.22
AIR_P_DETECTION: J12.21
AMS_ERR: D6.1 (K), R36.2
AMS_ERROR: R36.1
CANFD1+: J12.3
CANFD1-: J12.4
CANFD2+: J12.5
CANFD2-: J12.6
CAR+: J10.1
CAR-: J10.3
CAR_I: J8.2
CAR_I_REF: J8.1
CCO+: J5.1, T1.2, TP7.1
CCO-: J5.2, T1.1, TP8.1
CC_D+: J12.8
CC_D-: J12.7
CHARGER_DETECTION: J12.20
COM_MISO: IC11.13 (OUTC)
COM_MOSI: IC7.5 (IND)
COM_SCK: IC7.6 (INE)
DASH_LED: J12.29
FAN1-: J3.1
FAN2-: J3.2
FAN3-: J3.3
FAN4-: J3.4
FAN5-: J3.5
FAN6-: J3.6
FAN7-: J3.7
F_+3VISO: C48.1, F6.1, IC8.5 (VO), TP6.1
F_+5VISO: C40.1, C47.2, C77.1, F7.2, IC8.1 (VI), R22.2, TP4.1, U4.13 (SEL), U4.14 (VISO)
GND: C39.2, C45.2, C59.2, IC7.8 (GND1), IC11.9 (GND2), J2.A1 (GND), J2.A12 (GND), J2.B1 (GND), J2.B12 (GND), J2.S1 (SHIELD), J4.5, J4.7, J4.11, J12.16, J12.33, R91.1, R92.1, U4.2 (GNDP), U4.4 (SYNC)
GNDISO: C40.2, C44.2, C46.2, C47.1, C48.2, C77.2, IC7.9 (GND2), IC8.2 (GND), IC11.7 (INF), IC11.8 (GND1), J8.4, R22.1, TP5.1, U4.9 (GNDS), U4.15 (GNDS), U4.16 (GNDS)
ISO_ADC_MISO: IC11.3 (INB)
ISO_ADC_MOSI: IC7.15 (OUTA)
ISO_ADC_SCK: IC7.14 (OUTB)
ISO_COM_MISO: IC11.4 (INC)
ISO_COM_MOSI: IC7.12 (OUTD)
ISO_COM_SCK: IC7.11 (OUTE)
LED1: D3.1 (K), R27.2
LED2: D2.1 (K), R31.2
LED3: D1.1 (K), R34.2
LED_ERROR: R34.1
LED_OK: R27.1
LED_WARNING: R31.1
NRST: J4.12
unnamed: IC8.3 (NC), IC8.4 (NC)
unnamed: J2.A5 (CC1), R91.2
unnamed: J2.B5 (CC2), R92.2
unnamed: U4.6 (NC), U4.7 (NC), U4.8 (NC)
unnamed: U4.10 (NC), U4.11 (NC), U4.12 (NC)
OUT+: T1.3
OUT-: T1.4
SAFETY_IN: J12.10
SAFETY_OUT: J12.11
SDC_AIRS: J1.4, J1.5, J1.6
SPI_RDY: IC11.5 (IND), IC11.12 (OUTD)
SWCLK: J4.6
SWDIO: J4.4
TSMS: J12.1
UART_RX: J4.13
UART_TX: J4.14
USBR_D+: J2.A6 (D+), J2.B6 (D+)
USBR_D-: J2.A7 (D-), J2.B7 (D-)
VBUS+: J2.A4 (VBUS), J2.A9 (VBUS), J2.B4 (VBUS), J2.B9 (VBUS)
VDD: J12.17, J12.34
~ADC_CS: IC7.4 (INC)
~ADC_DRY: IC11.15 (OUTA)
~COM_CS: IC7.7 (INF)
~FLT: IC11.6 (INE), IC11.11 (OUTE)
~ISO_ADC_CS: IC7.13 (OUTC)
~ISO_ADC_DRY: IC11.2 (INA)
~ISO_COM_CS: IC7.10 (OUTF)

Notes on the sheet:
TI_IC ONLY
GALVANIC ISOLATION
FAN CONNECTORS
MAIN CONNECTOR
SAFETY
MCU
AIR CONNECTORS
SHARED
FAN CONTROL
LEDS
SWD CONNECTOR
USB CONNECTOR
13:PGR_TX 14:PRG_RX
ISO
AIR CONTROL
CONNECTORS
CONNECTIVITY
ISO POWER
POWER
ADC AND SPI
