PUT-Motorsport/PUTM_EV_AMS_MASTER/hardware/Power.kicad_sch

## KiCad design hardware/Power.kicad_sch (2025-06-25)

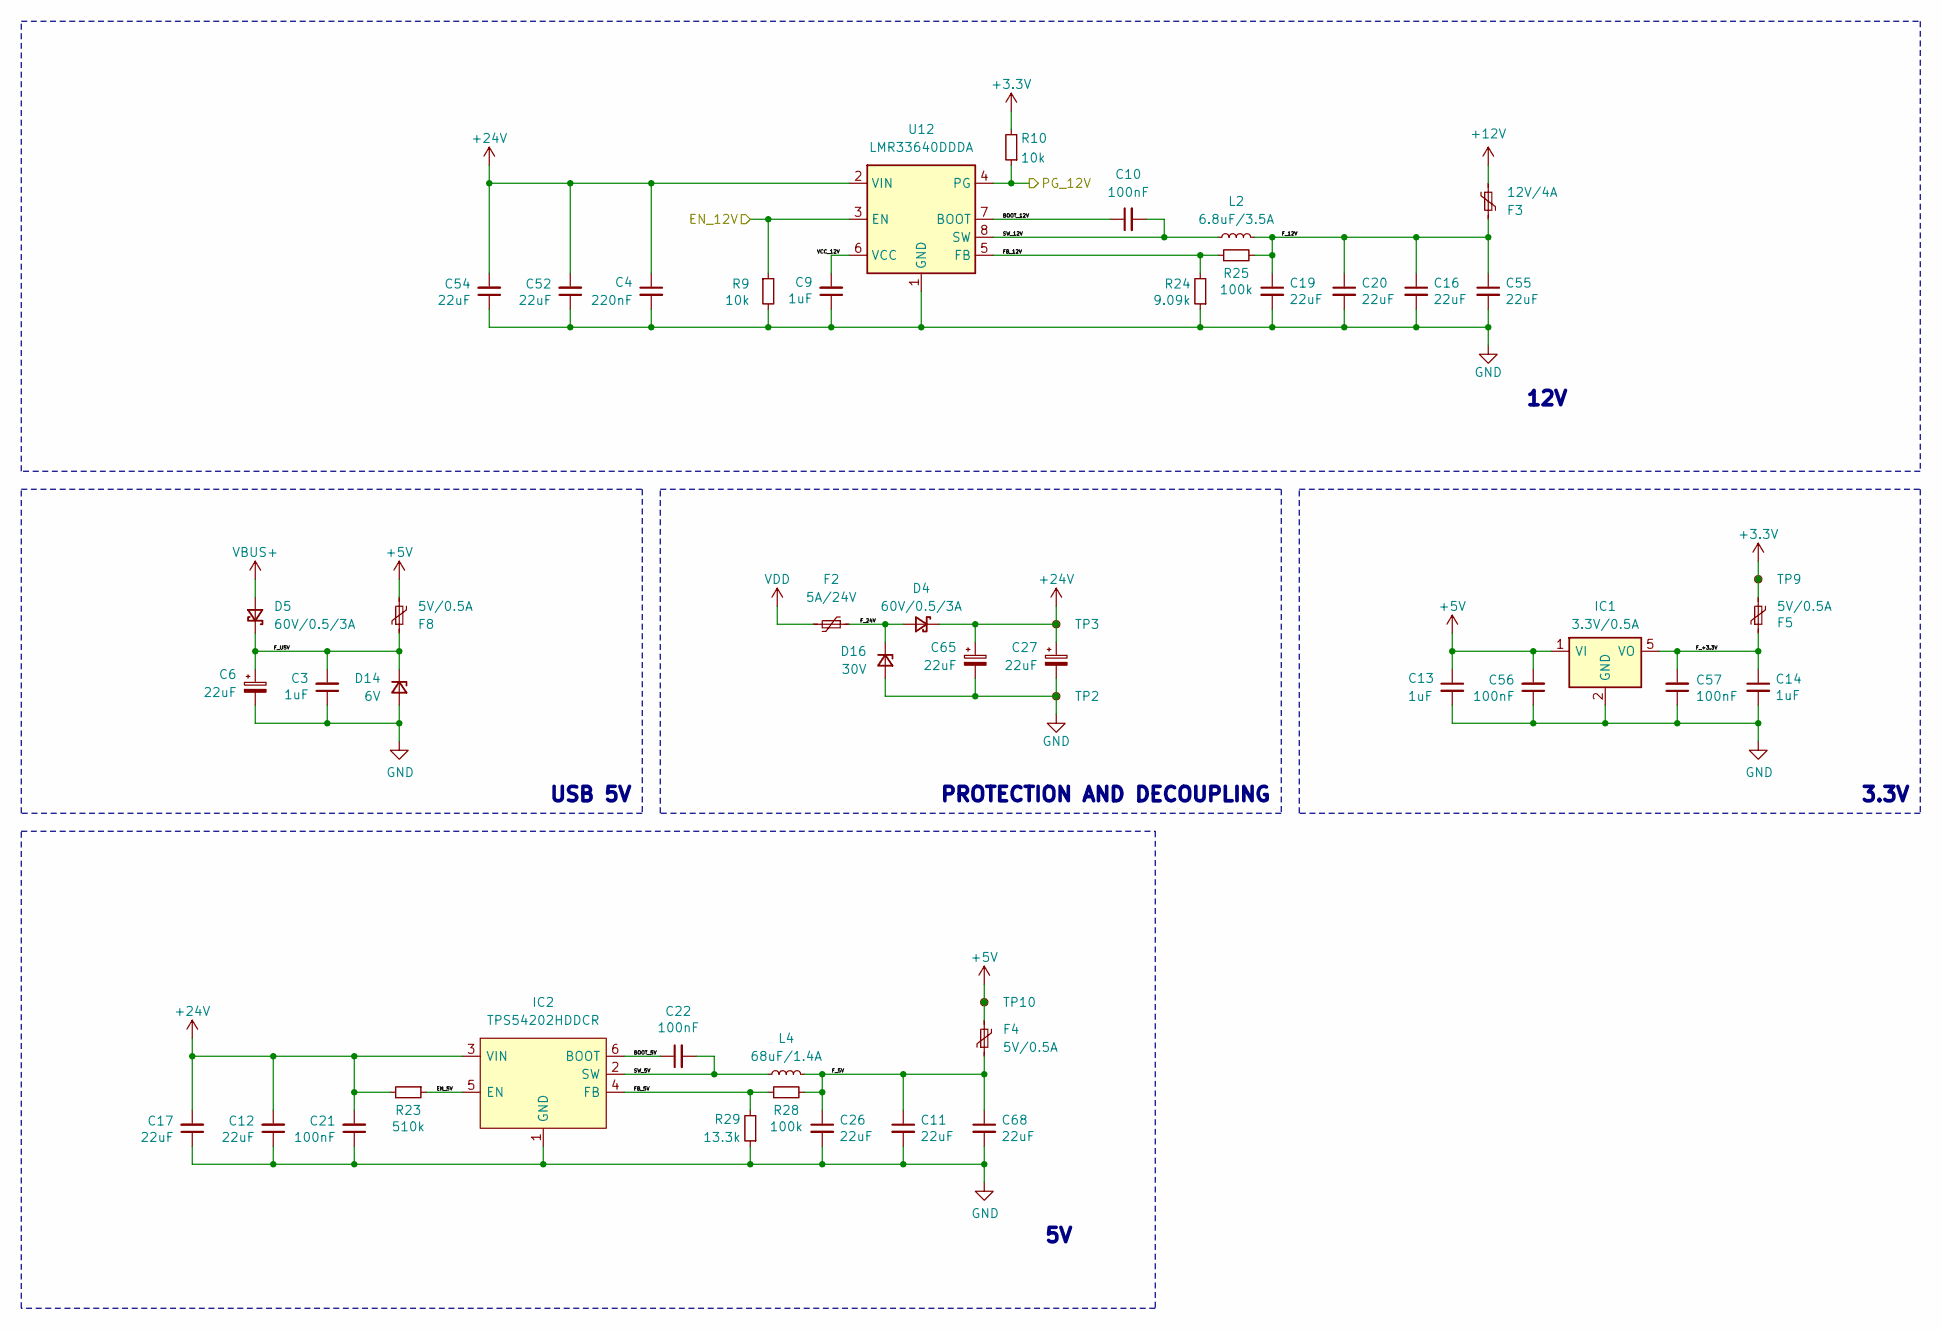
[picture p14: schematic Power.kicad_sch]

Parts:
C3, C9: 1uF; C_0603_1608Metric; Manufacturer_Part_Number C0603C104J3RACTU; Mouser Part Number 80-C0603C104J3R
C4: 220nF; C_0603_1608Metric; Manufacturer_Part_Number --; Mouser Part Number 963-H168SC7224KTCA1J
C6, C27, C65: 22uF; CP_Elec_4x5.8; Mouser Part Number 647-UCM1V220MCL1GS
C10, C21, C22, C56, C57: 100nF; C_0603_1608Metric; Manufacturer_Part_Number C0603C104J3RACTU; Mouser Part Number --
C11, C12, C16, C17, C19, C20, C26, C52, C54, C55, C68: 22uF; C_0805_2012Metric; Manufacturer_Part_Number CL21A107MQYNNWE; Mouser Part Number 810-C2012X5R1V226MAC
C13, C14: 1uF; C_0603_1608Metric; Manufacturer_Part_Number C0603C105K8RACTU; Mouser Part Number 80-C0603C104J3R
D4, D5: 60V/0.5/3A; D_SOD-123; Mouser Part Number 637-SKL36
D14: 6V; D_SOD-123; Mouser Part Number 637-SMF5.0A
D16: 30V; D_SOD-123; Mouser Part Number 750-TV02W260-G
F2: 5A/24V; Fuse_2920_7451Metric; Mouser Part Number 576-2920L500/24SLDR
F3: 12V/4A; Fuse_1206_3216Metric; Manufacturer_Part_Number 1206L400/12SLWR; Mouser Part Number 576-1206L400/12SLWR
F4, F5, F8: 5V/0.5A; Fuse_0805_2012Metric; Manufacturer_Part_Number 0ZCH0050FF2G; Mouser Part Number 530-0ZCH0050FF2G
IC1: 3.3V/0.5A; SOT-23-5; Mouser Part Number 595-TPS7B92033DBVR
IC2: TPS54202HDDCR; SOT-23-6; Mouser Part Number 595-TPS54202HDDCR
L2: 6.8uF/3.5A; L_TDK_VLS6045EX_VLS6045AF; Mouser Part Number 810-VLS6045AF-6R8M
L4: 68uF/1.4A; L_TDK_VLS6045EX_VLS6045AF; Mouser Part Number 810-VLS6045EX-680M
R9, R10: 10k; R_0603_1608Metric; Manufacturer_Part_Number RT0603DRE07100KL; Mouser Part Number --
R23: 510k; R_0603_1608Metric; Manufacturer_Part_Number RT0603DRD07510KL; Mouser Part Number 603-RT0603DRD07510KL
R24: 9.09k; R_0603_1608Metric; Manufacturer_Part_Number RT0603DRE0713K3L; Mouser Part Number 603-RT0603DRE0713K3L
R25, R28: 100k; R_0603_1608Metric; Manufacturer_Part_Number RT0603DRE07100KL; Mouser Part Number --
R29: 13.3k; R_0603_1608Metric; Manufacturer_Part_Number RT0603DRE0713K3L; Mouser Part Number 603-RT0603DRE0713K3L
TP2: TestPoint_Small; MountingHole_3.2mm_M3_Pad_Via; Mouser Part Number --
TP3, TP9, TP10: TestPoint_Small; TestPoint_THTPad_D1.0mm_Drill0.5mm; Mouser Part Number --
U12: LMR33640DDDA; Texas_HSOP-8-1EP_3.9x4.9mm_P1.27mm; Mouser Part Number 595-LMR33640DDDAR

Connections:
+3.3V: F5.2, R10.2, TP9.1
+5V: C13.1, C56.2, F4.2, F8.2, IC1.1 (VI), TP10.1
+12V: F3.1
+24V: C4.1, C12.2, C17.2, C21.2, C27.1, C52.2, C54.2, C65.1, D4.1 (K), IC2.3 (VIN), R23.2, TP3.1, U12.2 (VIN)
BOOT_5V: C22.1, IC2.6 (BOOT)
BOOT_12V: C10.1, U12.7 (BOOT)
EN_5V: IC2.5 (EN), R23.1
EN_12V: R9.1, U12.3 (EN)
FB_5V: IC2.4 (FB), R28.1, R29.2
FB_12V: R24.2, R25.1, U12.5 (FB)
F_5V: C11.1, C26.1, C68.1, F4.1, L4.2, R28.2
F_12V: C16.1, C19.1, C20.1, C55.1, F3.2, L2.2, R25.2
F_24V: D4.2 (A), D16.1 (K), F2.1
F_+3.3V: C14.1, C57.2, F5.1, IC1.5 (VO)
F_U5V: C3.2, C6.1, D5.1 (K), D14.1 (K), F8.1
GND: C3.1, C4.2, C6.2, C9.1, C11.2, C12.1, C13.2, C14.2, C16.2, C17.1, C19.2, C20.2, C21.1, C26.2, C27.2, C52.1, C54.1, C55.2, C56.1, C57.1, C65.2, C68.2, D14.2 (A), D16.2 (A), IC1.2 (GND), IC2.1 (GND), R9.2, R24.1, R29.1, TP2.1, U12.1 (GND), U12.9 (GND)
unnamed: IC1.3 (NC), IC1.4 (NC)
PG_12V: R10.1, U12.4 (PG)
SW_5V: C22.2, IC2.2 (SW), L4.1
SW_12V: C10.2, L2.1, U12.8 (SW)
VBUS+: D5.2 (A)
VCC_12V: C9.2, U12.6 (VCC)
VDD: F2.2

Notes on the sheet:
PROTECTION AND DECOUPLING
3.3V
12V
USB 5V
