PUT-Motorsport/PUTM_EV_AMS_MASTER/hardware/Safety.kicad_sch

## KiCad design hardware/Safety.kicad_sch (2025-06-25)

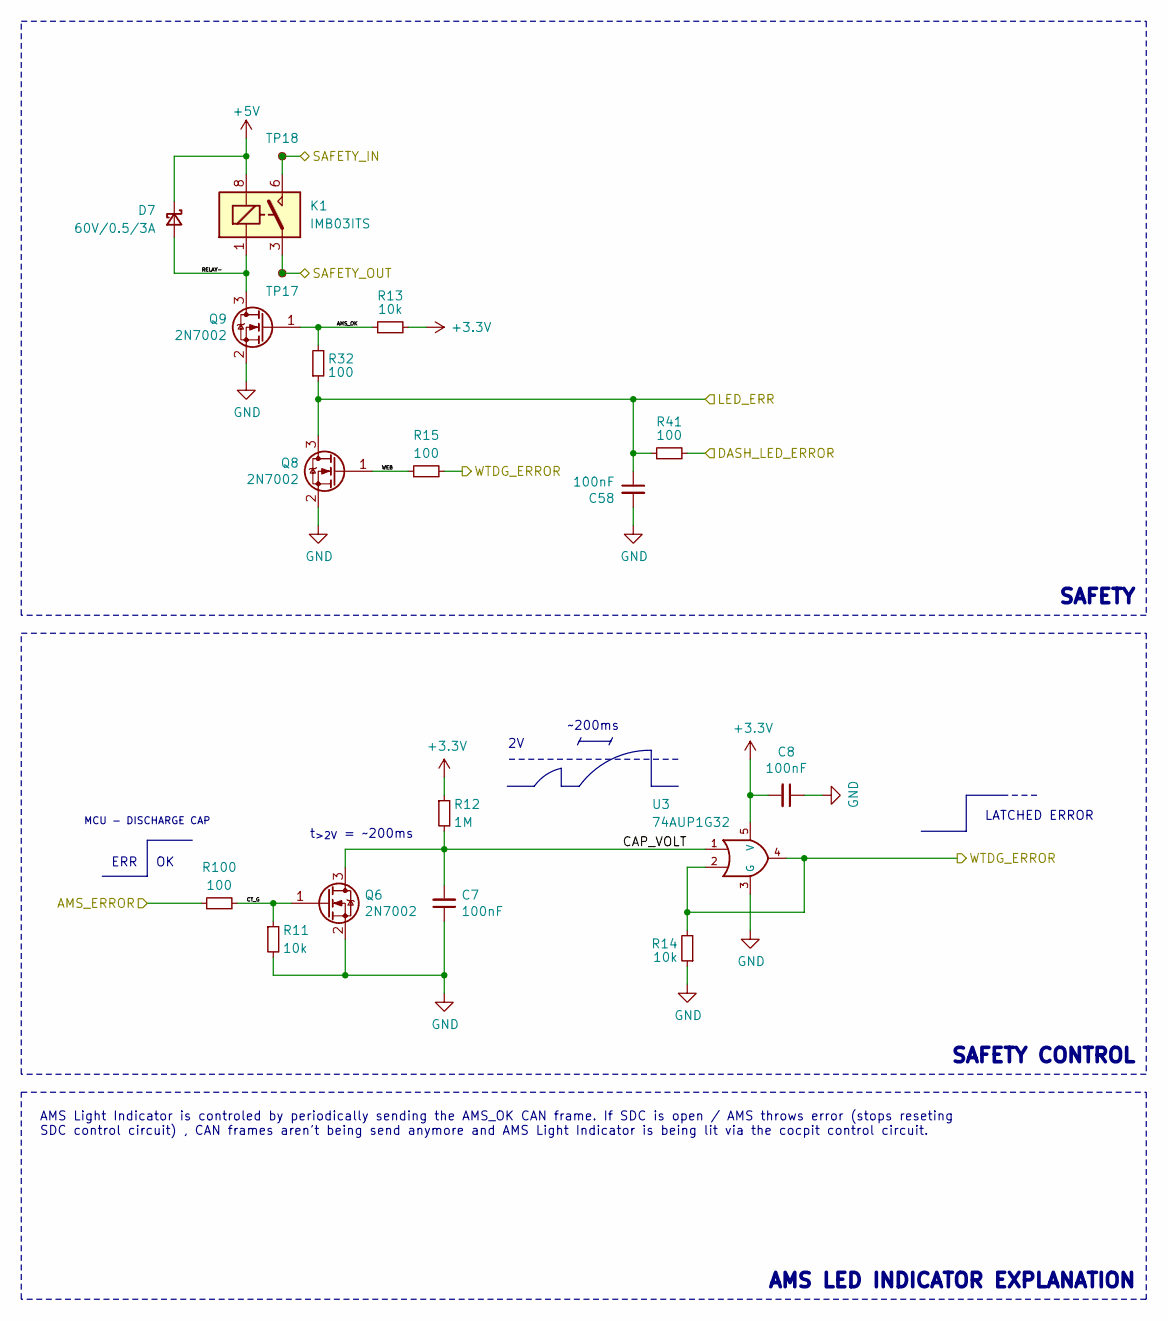
[picture p15: schematic Safety.kicad_sch]

Parts:
C7, C8, C58: 100nF; C_0603_1608Metric; Manufacturer_Part_Number --; Mouser Part Number --
D7: 60V/0.5/3A; D_SOD-123; Mouser Part Number 637-SKL36
K1: IMB03ITS; Mouser Part Number 655-IMB03ITS
Q6, Q8, Q9: 2N7002; SOT-23; Manufacturer_Part_Number --; Mouser Part Number 621-DMN65D8L-7
R11, R13, R14: 10k; R_0603_1608Metric; Manufacturer_Part_Number --; Mouser Part Number --
R12: 1M; R_0603_1608Metric; Manufacturer_Part_Number --; Mouser Part Number --
R15, R32, R41, R100: 100; R_0603_1608Metric; Manufacturer_Part_Number --; Mouser Part Number --
TP17, TP18: TestPoint_Small; TestPoint_THTPad_D1.0mm_Drill0.5mm; Mouser Part Number --
U3: 74AUP1G32; SOT-23-5; Manufacturer_Part_Number SN74AUP1G32DBVR; Mouser Part Number 595-SN74AUP1G32DBVR

Connections:
+3.3V: C8.2, R12.1, R13.2, U3.5 (V)
+5V: D7.1 (K), K1.8 (COIL_2)
AMS_ERROR: R100.1
AMS_OK: Q9.1 (G), R13.1, R32.2
CAP_VOLT: C7.2, Q6.3 (D), R12.2, U3.1
CT_G: Q6.1 (G), R11.1, R100.2
DASH_LED_ERROR: R41.2
GND: C7.1, C8.1, C58.2, Q6.2 (S), Q8.2 (S), Q9.2 (S), R11.2, R14.1, U3.3 (G)
LED_ERR: C58.1, Q8.3 (D), R32.1, R41.1
RELAY-: D7.2 (A), K1.1 (COIL_1), Q9.3 (D)
SAFETY_IN: K1.6 (NO), TP18.1
SAFETY_OUT: K1.3 (COM), TP17.1
WEB: Q8.1 (G), R15.1
WTDG_ERROR: R14.2, R15.2, U3.2, U3.4

Notes on the sheet:
MCU - DISCHARGE CAP
AMS Light Indicator is controled by periodically sending the AMS_OK CAN frame. If SDC is open / AMS throws error (stops reseting SDC control circuit) , CAN frames aren't being send anymore and AMS Light Indicator is being lit via the cocpit control circuit.
SAFETY CONTROL
~200ms
SAFETY
AMS LED INDICATOR EXPLANATION
ERR
LATCHED ERROR
t_{>2V} = ~200ms
