PUT-Motorsport/PUTM_EV_AMS_MASTER/firmware/PUTM_EV_AMS_MASTER_2025.ioc

Mcu.UserName=STM32H573RITx
PA0.GPIO_Label=FAN1_CTRL
PA0.Signal=S_TIM2_CH1
PA1.GPIO_Label=FAN2_CTRL
PA1.Signal=S_TIM2_CH2
PA10.GPIO_Label=UART_USB_RX
PA10.Signal=USART1_RX
PA11.GPIO_Label=UART_DEBUG_RX
PA11.Signal=UART4_RX
PA12.GPIO_Label=UART_DEBUG_TX
PA12.Signal=UART4_TX
PA13(JTMS/SWDIO).Signal=DEBUG_JTMS-SWDIO
PA14(JTCK/SWCLK).Signal=DEBUG_JTCK-SWCLK
PA2.GPIO_Label=FAN3_CTRL
PA2.Signal=S_TIM2_CH3
PA3.GPIO_Label=FAN4_CTRL
PA3.Signal=S_TIM2_CH4
PA4.GPIO_Label=ADC_NSS
PA4.Signal=SPI1_NSS
PA5.GPIO_Label=ADC_SCK
PA5.Signal=SPI1_SCK
PA6.GPIO_Label=ADC_MISO
PA6.Signal=SPI1_MISO
PA7.GPIO_Label=ADC_MOSI
PA7.Signal=SPI1_MOSI
PA9.GPIO_Label=UART_USB_TX
PA9.Signal=USART1_TX
PB0.Signal=ADCx_INP9
PB10.GPIO_Label=UART_COM_TX
PB10.Signal=USART3_TX
PB12.GPIO_Label=SIG_AIR_PRE
PB12.Signal=GPIO_Output
PB13.GPIO_Label=SIG_AIR_P
PB13.Signal=GPIO_Output
PB14.GPIO_Label=SIG_AIR_M
PB14.Signal=GPIO_Output
PB15.GPIO_Label=NFLT
PB15.Signal=GPIO_Input
PB2.GPIO_Label=SIG_AMS_ERROR
PB2.Signal=GPIO_Output
PB3(JTDO/TRACESWO).GPIO_Label=LED_WARNING
PB3(JTDO/TRACESWO).Signal=GPIO_Output
PB4(NJTRST).GPIO_Label=LED_OK
PB4(NJTRST).Signal=GPIO_Output
PB5.Signal=FDCAN2_RX
PB6.Signal=FDCAN2_TX
PB7.Signal=FDCAN1_TX
PB8.Signal=FDCAN1_RX
PC0.GPIO_Label=DET_AIR_PRE
PC0.Signal=GPIO_Input
PC1.GPIO_Label=DET_TSMS
PC1.Signal=GPIO_Input
PC13.GPIO_Label=USB_RESET
PC13.Signal=GPIO_Output
PC15-OSC32_OUT(OSC32_OUT).GPIO_Label=DET_AIR_P
PC15-OSC32_OUT(OSC32_OUT).Signal=GPIO_Input
PC2.GPIO_Label=DET_AIR_M
PC2.Signal=GPIO_Input
PC3.GPIO_Label=DET_CHARGER
PC3.Signal=GPIO_Input
PC4.GPIO_Label=UART_COM_RX
PC4.Signal=USART3_RX
PC5.GPIO_Label=NADC_DRY
PC5.Signal=GPXTI5
PD2.GPIO_Label=LED_ERROR
PD2.Signal=GPIO_Output
