PUT-Motorsport/PUTM_EV_AMS_MASTER/firmware/Core/Src/main.c

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
/* Includes ------------------------------------------------------------------*/
#include "app_threadx.h"
#include "main.h"
#include "adc.h"
#include "crc.h"
#include "fdcan.h"
#include "flash.h"
#include "gpdma.h"
#include "icache.h"
#include "spi.h"
#include "tim.h"
#include "usart.h"
#include "gpio.h"


void SystemClock_Config(void);
/**
  * @brief  The application entry point.
  * @retval int
  */
int main(void)
{

  /* MCU Configuration--------------------------------------------------------*/

  /* Reset of all peripherals, Initializes the Flash interface and the Systick. */
  HAL_Init();

  /* Configure the system clock */
  SystemClock_Config();

  /* Initialize all configured peripherals */
  MX_GPIO_Init();
  MX_GPDMA1_Init();
  MX_GPDMA2_Init();
  MX_FDCAN1_Init();
  MX_FDCAN2_Init();
  MX_SPI1_Init();
  MX_USART1_UART_Init();
  MX_ICACHE_Init();
  MX_TIM2_Init();
  MX_UART4_Init();
  MX_ADC1_Init();
  MX_USART3_UART_Init();
  MX_CRC_Init();
  MX_FLASH_Init();
  MX_ThreadX_Init();

  /* We should never get here as control is now taken by the scheduler */

  /* Infinite loop */
  /* USER CODE BEGIN WHILE */
  while (1)
  {
    /* USER CODE END WHILE */

    /* USER CODE BEGIN 3 */
  }
  /* USER CODE END 3 */
}

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
/* USER CODE BEGIN 4 */
int __io_putchar(int ch) {
  // Code to write character 'ch' on the UART
  while(!(USART1->ISR & USART_ISR_TXE));
  USART1->TDR = ch;
  return ch;  //  On success, the character written is returned.
  //  If a writing error occurs, EOF is returned and the error indicator (ferror) is set.
}
/* USER CODE END 4 */

/**
  * @brief  Period elapsed callback in non blocking mode
  * @note   This function is called  when TIM1 interrupt took place, inside
  * HAL_TIM_IRQHandler(). It makes a direct call to HAL_IncTick() to increment
  * a global variable "uwTick" used as application time base.
  * @param  htim : TIM handle
  * @retval None
  */
void HAL_TIM_PeriodElapsedCallback(TIM_HandleTypeDef *htim)
{
  if (htim->Instance == TIM1)
  {
    HAL_IncTick();
  }
}

/**
  * @brief  This function is executed in case of error occurrence.
  * @retval None
  */
void Error_Handler(void)
{
  /* USER CODE BEGIN Error_Handler_Debug */
  /* User can add his own implementation to report the HAL error return state */
  
  /* Hard coded state */
  HAL_GPIO_WritePin(LED_OK_GPIO_Port, LED_OK_Pin, GPIO_PIN_SET);
  HAL_GPIO_WritePin(LED_WARNING_GPIO_Port, LED_WARNING_Pin, GPIO_PIN_SET);
  HAL_GPIO_WritePin(SIG_AMS_ERROR_GPIO_Port, SIG_AMS_ERROR_Pin, GPIO_PIN_RESET);
  HAL_GPIO_WritePin(LED_ERROR_GPIO_Port, LED_ERROR_Pin, GPIO_PIN_RESET);
  while (1)
  {

  }
  /* USER CODE END Error_Handler_Debug */
}
#ifdef USE_FULL_ASSERT
/**
  * @brief  Reports the name of the source file and the source line number
  *         where the assert_param error has occurred.
  * @param  file: pointer to the source file name
  * @param  line: assert_param error line source number
  * @retval None
  */
void assert_failed(uint8_t *file, uint32_t line)
{
  /* USER CODE BEGIN 6 */
  /* User can add his own implementation to report the file name and line number,
     ex: printf("Wrong parameters value: file %s on line %d\r\n", file, line) */
  /* USER CODE END 6 */
}
#endif /* USE_FULL_ASSERT */
