PUT-Motorsport/PUTM_EV_AMS_MASTER/firmware/Core/Inc/main.h

#define USB_RESET_Pin GPIO_PIN_13
#define USB_RESET_GPIO_Port GPIOC
#define DET_AIR_P_Pin GPIO_PIN_15
#define DET_AIR_P_GPIO_Port GPIOC
#define DET_AIR_PRE_Pin GPIO_PIN_0
#define DET_AIR_PRE_GPIO_Port GPIOC
#define DET_TSMS_Pin GPIO_PIN_1
#define DET_TSMS_GPIO_Port GPIOC
#define DET_AIR_M_Pin GPIO_PIN_2
#define DET_AIR_M_GPIO_Port GPIOC
#define DET_CHARGER_Pin GPIO_PIN_3
#define DET_CHARGER_GPIO_Port GPIOC
#define FAN1_CTRL_Pin GPIO_PIN_0
#define FAN1_CTRL_GPIO_Port GPIOA
#define FAN2_CTRL_Pin GPIO_PIN_1
#define FAN2_CTRL_GPIO_Port GPIOA
#define FAN3_CTRL_Pin GPIO_PIN_2
#define FAN3_CTRL_GPIO_Port GPIOA
#define FAN4_CTRL_Pin GPIO_PIN_3
#define FAN4_CTRL_GPIO_Port GPIOA
#define ADC_NSS_Pin GPIO_PIN_4
#define ADC_NSS_GPIO_Port GPIOA
#define ADC_SCK_Pin GPIO_PIN_5
#define ADC_SCK_GPIO_Port GPIOA
#define ADC_MISO_Pin GPIO_PIN_6
#define ADC_MISO_GPIO_Port GPIOA
#define ADC_MOSI_Pin GPIO_PIN_7
#define ADC_MOSI_GPIO_Port GPIOA
#define UART_COM_RX_Pin GPIO_PIN_4
#define UART_COM_RX_GPIO_Port GPIOC
#define NADC_DRY_Pin GPIO_PIN_5
#define NADC_DRY_GPIO_Port GPIOC
#define SIG_AMS_ERROR_Pin GPIO_PIN_2
#define SIG_AMS_ERROR_GPIO_Port GPIOB
#define UART_COM_TX_Pin GPIO_PIN_10
#define UART_COM_TX_GPIO_Port GPIOB
#define SIG_AIR_PRE_Pin GPIO_PIN_12
#define SIG_AIR_PRE_GPIO_Port GPIOB
#define SIG_AIR_P_Pin GPIO_PIN_13
#define SIG_AIR_P_GPIO_Port GPIOB
#define SIG_AIR_M_Pin GPIO_PIN_14
#define SIG_AIR_M_GPIO_Port GPIOB
#define NFLT_Pin GPIO_PIN_15
#define NFLT_GPIO_Port GPIOB
#define UART_USB_TX_Pin GPIO_PIN_9
#define UART_USB_TX_GPIO_Port GPIOA
#define UART_USB_RX_Pin GPIO_PIN_10
#define UART_USB_RX_GPIO_Port GPIOA
#define UART_DEBUG_RX_Pin GPIO_PIN_11
#define UART_DEBUG_RX_GPIO_Port GPIOA
#define UART_DEBUG_TX_Pin GPIO_PIN_12
#define UART_DEBUG_TX_GPIO_Port GPIOA
#define LED_ERROR_Pin GPIO_PIN_2
#define LED_ERROR_GPIO_Port GPIOD
#define LED_WARNING_Pin GPIO_PIN_3
#define LED_WARNING_GPIO_Port GPIOB
#define LED_OK_Pin GPIO_PIN_4
#define LED_OK_GPIO_Port GPIOB
