PUT-Motorsport/PUTM_EV_AMS_MASTER/documentation/vscode/cpp/main.cpp

/******************************************************************************

                              Online C++ Compiler.
               Code, Compile, Run and Debug C++ program online.
Write your code in this editor and press "Run" button to compile and execute it.

*******************************************************************************/

#include <iostream>

#include "cstring"

#include "string_view"
#include "format"
#include "cstdint"

template<size_t BUFFER_SIZE, typename MESSAGE_INDEX_TYPE = uint16_t> // requires ebebe
class Logger
{
private:
    using MSG_I_TYPE = MESSAGE_INDEX_TYPE;
protected:
    char __buffer[BUFFER_SIZE];
    MSG_I_TYPE __size = BUFFER_SIZE;
    MSG_I_TYPE __index { 0 };
    MSG_I_TYPE __message_count { 0 };
protected:
    friend class Iterator;
public:
    /**
     *  @brief  This function logs a message to the logger
     *  @param  `message` message to log
     *  @note   The message is expected to be terminated with a newline character.
     *          If the message is too long, it will be truncated to fit in the buffer
     *          and the rest of the message will be discarded.
     *          The message is prefixed with "=E= " to indicate that it is an error message.
     *          The function will not log the message if there is not enough space in
     *          the buffer to fit the message.
     */
    void log_error(std::string_view message, uint32_t tick = 0)
    {
        MSG_I_TYPE *__ptr;
        
        /* include null-termination */
        if(__index + message.size() + 17 + sizeof(MSG_I_TYPE) >= __size) return;
        if(message.size() == 0) return; // No message to log
        std::format_to_n(__buffer + __index, __size - __index, "{:09d} ERR: {} \n", tick, message);
        __index += message.size() + 17;
        __ptr = (MSG_I_TYPE*)(__buffer + __size - sizeof(MSG_I_TYPE));
        /* store message 'end' at the end of the buffer */
        *__ptr = __index;
        __size -= sizeof(MSG_I_TYPE);
        __message_count++;
    }
public:
    /**
    *  @brief  This function clears the logger
    *  @note   This function will reset the index, message count and size of the logger.
    *          It will not clear the buffer, so the messages will still be there.
    */
    void clear()
    {
        __index = 0;
        __message_count = 0;
        __size = 0;
    }
public:
    std::string_view get_buffer() const
    {
        return std::string_view(__buffer, BUFFER_SIZE);
    }
public:
    std::string_view get_buffer_and_clear()
    {
        std::string_view view;
        
        view = std::string_view(__buffer, __index);
        this->clear();
        return view;
    }
protected:
    /**
     *  @brief  This function returns the range of the message at the given index
     *  @param  `message_index` index of the message to return
     *  @note   This function will return an empty string if the index is out of bounds
     *  @return std::pair<MSG_I_TYPE, MSG_I_TYPE> of the begin and end of the message at the given index
     */
    std::pair<MSG_I_TYPE, MSG_I_TYPE> get_range(size_t message_index) const
    {
        MSG_I_TYPE *__ptr_begin { nullptr };
        MSG_I_TYPE *__ptr_end { nullptr };
        size_t __begin { 0 };
        size_t __end { 0 };

        if(__message_count == 0) return { 0, 0 }; // No messages
        if(message_index >= __message_count) return { 0, 0 }; // Out of bounds
        
        __ptr_end = (MSG_I_TYPE*)(__buffer + BUFFER_SIZE - sizeof(MSG_I_TYPE) * (message_index + 1));
        __end = *__ptr_end;
        if(message_index != 0)
        {
            MSG_I_TYPE *__ptr_begin = __ptr_end + 1;
            __begin = *__ptr_begin;
        }
        
        return { __begin, __end };
    }
public:
    /**
     *  @brief  This function returns a message at the given index
     *  @param  `message_index` index of the message to return
     *  @note   This function will return an empty string if the index is out of bounds
     *  @return std::string_view of the message at the given index
     *  @note   The message is returned as a string_view, so it is not copied, but rather a view of the original buffer.
     *          The message is expected to be terminated with a newline character.
     *          If the index is out of bounds, an empty string_view is returned.
     *          The messages are separated by newline characters, so the function will return
     *          the message at the given index, where index 0 is the first message.
     *  @warning    This function does not check if the index is valid, so it is up to the user to ensure that the index is within bounds.
     *              Repeated usage of this function can slow down the system.
     */
    std::string_view get_message(size_t message_index) const
    {
        // MSG_I_TYPE *__ptr_begin { nullptr };
        // MSG_I_TYPE *__ptr_end { nullptr };
        // size_t __begin { 0 };
        // size_t __end { 0 };
        
        // if(message_index >= __message_count) return std::string_view(""); // Out of bounds
        
        // __ptr_end = (MSG_I_TYPE*)(__buffer + __size - sizeof(MSG_I_TYPE) * __message_count)
        // __end = *__ptr_end;
        // if(message_count != 1)
        // {
        //     MSG_I_TYPE *__ptr_begin = (MSG_I_TYPE*)(__buffer + __size - sizeof(MSG_I_TYPE) * (__message_count - 1))
        //     __begin = *__ptr_begin;
        // }
        
        if(__message_count == 0) return std::string_view(); // No messages
        if(message_index >= __message_count) return std::string_view(); // Out of bounds

        auto [__begin, __end] = this->get_range(message_index);
        
        return std::string_view(__buffer + __begin, __end - __begin);
    }
public:
    bool is_full() const
    {
        return __index >= __size;
    }
public:
    bool is_empty() const
    {
        return __message_count == 0;
    }
public:
    size_t size() const
    {
        return __index;
    }
public:
    size_t free_space() const
    {
        return __size - __index;
    }
public:
    size_t message_count() const
    {
        return __message_count;
    }
public:
    class Iterator
    {
    private:
        const Logger<BUFFER_SIZE> *__logger;
        size_t __index;
    public:
        Iterator(const Logger<BUFFER_SIZE> *logger, size_t index) : __logger(logger), __index(index) { }
        std::string_view operator*() const
        {
            return __logger->get_message(this->__index);
        }  
        Iterator& operator++()
        {
            this->__index++;

            return *this;
        }
        bool operator!=(const Iterator& other) const
        {
            return this->__index != other.__index;
        }
        bool operator==(const Iterator& other) const
        {
            return this->__index == other.__index;
        }
    };
public:
    using iterator = Iterator;
    using const_iterator = Iterator;
public:
    /**
     *  @brief  Returns an iterator to the beginning of the logger
     *  @return Iterator to the beginning of the logger
     */ 
    Iterator begin() const
    {
        return Iterator(this, 0);
    }
public:
    /**
     *  @brief  Returns an iterator to the end of the logger
     *  @return Iterator to the end of the logger
     */
    Iterator end() const
    {
        return Iterator(this, this->__message_count);
    }
};

Logger<128> logger;

int main()
{
    logger.log_error("A", 0);
    for(size_t i = 1; i < 128; i++) logger.log_error("B", i);
    // std::cout << logger.get_buffer();
    // for(size_t i = 0; i < logger.message_count(); i++)
    // {
    //     auto message = logger.get_message(i);
    //     std::cout << message << std::endl;
    // }
    for(auto message : logger)
    {
        std::cout << message << std::endl;
    }

    return 0;
}
