PUT-Motorsport/PUTM_EV_AMS_MASTER/firmware/Core/Inc/bq79616.hpp

/*
 * bq79616.hpp
 *
 *  Created on: Feb 18, 2025
 *      Author: lenovo
 */

#ifndef INC_BQ79616_HPP_
#define INC_BQ79616_HPP_

#include "main.h"
#include "concepts"
#include "utility"

namespace Bq
{
	namespace Utils
	{
		struct IReg { };

		template<size_t START, size_t OFFSET = 0>
		struct IAddress
		{
		    static inline constexpr int ADDRESS = START + OFFSET;
		};

		template<typename T>
		concept IsReg = std::is_base_of<IReg, T>::value and not std::is_polymorphic<T>::value and sizeof(T) == 1;

		template<typename T>
		int constexpr sta() { return T::ADDRESS; }

		struct Dir0AddrOtp : public IReg, IAddress<0x0000>
		{
			uint8_t undef { 0x00 };
		};

		struct __packed Dir1AddrOtp : public IReg, IAddress<0x0001>
		{
			uint8_t undef { 0x00 };
		};

		template<size_t T>
		concept IsMiscReg = T >= 1 and T <= 9;

		template<size_t MiscReg> requires IsMiscReg<MiscReg>
		struct __packed CustMisc : public IReg
		{
			uint8_t data;
		};

		struct __packed Dir0Addr : public IReg, IAddress<0x0306>
		{
			uint8_t undef;
		};

		struct __packed Dir1Addr : public IReg, IAddress<0x0307>
		{
			uint8_t undef;
		};

		struct __packed PartId : public IReg, IAddress<0x0500>
		{
			uint8_t part_id;
		};

		struct __packed DevRevId : public IReg, IAddress<0x0e00>
		{
			uint8_t undef;
		};

		template<size_t T>
		concept IsDieIdReg = T >= 1 and T <= 9;

		template<size_t DieIdReg> requires IsDieIdReg<DieIdReg>
		struct __packed DieId : public IReg
		{
			uint8_t id;
		};
		//undef

		struct __packed DevConf : public IReg, IAddress<0x0002>
		{
		public:
			uint8_t hb_en : 1 { 0b0 };
			uint8_t ftone_en : 1 { 0b0 };
			uint8_t nfault_en : 1 { 0b1 };
			uint8_t two_stop_en : 1 { 0b0 };
			uint8_t fcomm_en : 1 { 0b1 };
			uint8_t multidrop_en : 1 { 0b0 };
			uint8_t no_adj_cb : 1 { 0b1 };
		private:
			uint8_t reserved : 1 { 0b0 };
		};

		enum struct __packed NumCell : uint8_t
		{
			_6S,
			_7S,
			_8S,
			_9S,
			_10S,
			_11S,
			_12S,
			_13S,
			_14S,
			_15S,
			_16S
		};

		struct __packed ActiveCell : public IReg, IAddress<0x0003>
		{
		public:
			NumCell num_cell : 4 { NumCell::_16S };
		private:
			uint8_t spare : 4 { 0b0000 };
		};

		struct __packed BbvcPosn1 : public IReg
		{
			uint8_t cell9  : 1 { 0b0 };
			uint8_t cell10 : 1 { 0b0 };
			uint8_t cell11 : 1 { 0b0 };
			uint8_t cell12 : 1 { 0b0 };
			uint8_t cell13 : 1 { 0b0 };
			uint8_t cell14 : 1 { 0b0 };
			uint8_t cell15 : 1 { 0b0 };
			uint8_t cell16 : 1 { 0b0 };
		};
		//undef

		struct __packed BbvcPosn2 : public IReg
		{
			uint8_t cell1 : 1 { 0b0 };
			uint8_t cell2 : 1 { 0b0 };
			uint8_t cell3 : 1 { 0b0 };
			uint8_t cell4 : 1 { 0b0 };
			uint8_t cell5 : 1 { 0b0 };
			uint8_t cell6 : 1 { 0b0 };
			uint8_t cell7 : 1 { 0b0 };
			uint8_t cell9 : 1 { 0b0 };
		};
		//undef

		enum struct __packed SleepTime : uint8_t
		{
			No,
			_5s,
			_10s,
			_1min,
			_10min,
			_30min,
			_1h,
			_2h
		};

		enum struct __packed TWarnThr : uint8_t
		{
			_85C,
			_95C,
			_105C,
			_115C
		};

		struct __packed PwrTransitConf : public IReg, IAddress<0x0018>
		{
		public:
			SleepTime slp_time : 3 { 0b000 };
			TWarnThr twarn_thr : 2 { 0b11 };
		private:
			uint8_t spare : 3 { 0b000 };
		};

		enum struct __packed CtsTime : uint8_t
		{
			No,
			_100ms,
			_2s,
			_10s,
			_10min,
			_30min,
			_1h
		};

		enum struct __packed CtlTime : uint8_t
		{
			No,
			_100ms,
			_2s,
			_10s,
			_1min,
			_10min,
			_30min,
			_1h
		};

		struct __packed CommTimeoutConf : public IReg, IAddress<0x0019>
		{
		public:
			CtlTime ctl_time : 3 { 0b000 };
			bool ctl_act : 1 { 0b0 };
			CtsTime cts_time : 3 { 0b000 };
		private:
			uint8_t spare : 1 { 0b0 };
		};

		struct __packed TxHoldOff : public IReg, IAddress<0x001a>
		{
			uint8_t dly { 0x00 };
		};

		struct __packed StackResponse : public IReg, IAddress<0x0029>
		{
		public:
			uint8_t dly : 6 { 0b000000 };
		private:
			uint8_t spare : 2 { 0b00 };
		};

		enum struct __packed Loc : uint8_t
		{
			No,
			Undef,
		};

		struct __packed BBPLock : public IReg
		{
		public:
			Loc lock : 5 { 0b00000 };
		private:
			uint8_t spare : 3 { 0b000 };
		};
		//undef

		struct __packed CommCtrl : public IReg, IAddress<0x0308>
		{
		public:
			bool top_stack : 1 { 0b0 };
			bool stack_dev : 1 { 0b0 };
		private:
			uint8_t reserved : 6 { 0b000000 };
		};

		struct __packed Control1 : public IReg, IAddress<0x0309>
		{
			bool addr_wr : 1 { 0b0 };
			bool soft_reset : 1 { 0b0 };
			bool goto_sleep : 1 { 0b0 };
			bool goto_shutdown : 1 { 0b0 };
			bool send_slptoact : 1 { 0b0 };
			bool send_wake : 1 { 0b0 };
			bool send_shutdown : 1 { 0b0 };
			bool dir_sel : 1 { 0b0 };
		};

		struct __packed Control2 : public IReg, IAddress<0x030a>
		{
		public:
			bool tsref_en : 1 { 0b0 };
			bool send_hw_reset : 1 { 0b0 };
		private:
			uint8_t reserved : 6 { 0b000000 };
		};

		enum struct __packed Byte : uint16_t
		{
			Hi,
			Lo
		};

		template<Byte T>
		concept IsByte = T == Byte::Hi or T == Byte::Lo;

		template<Byte B> requires IsByte<B>
		struct __packed CustCrc: public IReg
		{
			uint8_t undef { 0x00 };
		};

		template<Byte B> requires IsByte<B>
		struct __packed CustCrcRslt : public IReg
		{
			uint8_t undef { 0x00 };
		};
		//undef

		struct __packed DiagStat : public IReg, IAddress<0x0526>
		{
		public:
			bool drdy_bist_pwr : 1 { 0b0 };
			bool drdy_bist_ovuv : 1 { 0b0 };
			bool drdy_bist_otut : 1 { 0b0 };
			bool drdy_ovuv : 1 { 0b0 };
			bool drdy_otut : 1 { 0b0 };
		private:
			uint8_t reserved : 3 { 0b000 };
		};

		struct __packed AdcStat1 : public IReg, IAddress<0x0527>
		{
		public:
			bool drdy_main_adc : 1 { 0b0 };
			bool drdy_aux_misc : 1 { 0b0 };
			bool drdy_aux_cell : 1 { 0b0 };
			bool drdy_aux_gpio : 1 { 0b0 };
		private:
			uint8_t reserved : 4 { 0b0 };
		};

		struct __packed AdcStat2 : public IReg, IAddress<0x0528>
		{
		public:
			bool drdy_vccb : 1 { 0b0 };
			bool drdy_cbfet : 1 { 0b0 };
			bool drdy_cbow : 1 { 0b0 };
			bool drdy_vcow : 1 { 0b0 };
			bool drdy_gpio : 1 { 0b0 };
			bool drdy_lpf : 1 { 0b0 };
		private:
			uint8_t reserved : 2 { 0b00 };
		};

		struct __packed GpioStat : public IReg, IAddress<0x052a>
		{
			bool gpio1 : 1 { 0b0 };
			bool gpio2 : 1 { 0b0 };
			bool gpio3 : 1 { 0b0 };
			bool gpio4 : 1 { 0b0 };
			bool gpio5 : 1 { 0b0 };
			bool gpio6 : 1 { 0b0 };
			bool gpio7 : 1 { 0b0 };
			bool gpio8 : 1 { 0b0 };
		};

		struct __packed BalStat : public IReg, IAddress<0x052b>
		{
			bool cb_done : 1 { 0b0 };
			bool mb_done : 1 { 0b0 };
			bool abortflt : 1 { 0b0 };
			bool cb_run : 1 { 0b0 };
			bool mb_run : 1 { 0b0 };
			bool cb_inpause : 1 { 0b0 };
			bool ot_pause_det : 1 { 0b0 };
			bool invalid_cbconf : 1 { 0b0 };
		};

		struct __packed DevStat : public IReg, IAddress<0x052c>
		{
		public:
			bool main_run : 1 { 0b0 };
			bool aux_run : 1 { 0b0 };
		private:
			bool reserved1 : 1 { 0b0 };
		public:
			bool ovuv_run : 1 { 0b0 };
			bool otut_run : 1 { 0b0 };
			bool cust_crc_done : 1 { 0b0 };
			bool fact_crc_done : 1 { 0b0 };
		private:
			bool reserved2 : 1 { 0b0 };
		};

//		enum struct __packed SettleTime
//		{
//			_4_3ms,
//			_2_3ms,
//			_1_3ms,
//			Reserved
//		};
//
//		enum struct __packed CutOff
//		{
//			_6_5Hz,
//			_13Hz,
//			_26Hz,
//			_53Hz,
//			_111
//		};

		struct __packed AdcConf1 : public IReg
		{
			uint8_t undef { 0x00 };
		};
		//undef

		struct __packed AdcConf2 : public IReg
		{
			uint8_t undef { 0x00 };
		};
		//undef

		struct __packed MainAdcCal1 : public IReg
		{
			uint8_t undef { 0x00 };
		};
		//undef

		struct __packed MainAdcCal2 : public IReg
		{
			uint8_t undef { 0x00 };
		};
		//undef

		struct __packed AuxAdcCal1 : public IReg
		{
			uint8_t undef { 0x00 };
		};
		//undef

		struct __packed AuxAdcCal2 : public IReg
		{
			uint8_t undef { 0x00 };
		};
		//undef

		enum struct __packed MainMode : uint8_t
		{
			No,
			Single,
			Continous
		};

		struct __packed AdcCtrl1 : public IReg, IAddress<0x030d>
		{
		public:
			MainMode main_mode : 2 { 0b00 };
			bool main_go : 1 { 0b0 };
			bool lpf_cell_en : 1 { 0b0 };
			bool lpf_bb_en : 1 { 0b0 };
		private:
			uint8_t reserved : 3 { 0b000 };
		};

		// those are kept at zero so whatever
		struct __packed AdcCtrl2 : public IReg
		{
			uint8_t undef { 0x00 };
		};
		//undef

		// those are kept at zero so whatever
		struct __packed AdcCtrl3 : public IReg
		{
			uint8_t undef { 0x00 };
		};
		//undef

		template<size_t T>
		concept IsCellChannel = T >= 1 and T <= 16;

		template<Byte BYTE, size_t CHANNEL> requires IsCellChannel<CHANNEL> and IsByte<BYTE>
		struct __packed VCell : public IReg, IAddress<0x0568, size_t(BYTE) + CHANNEL>
		{
			uint8_t result;
		};


		template<Byte B> requires IsByte<B>
		struct __packed BusBar : public IReg
		{
			uint8_t result;
		};
		//undef

		template<Byte BYTE> requires IsByte<BYTE>
		struct __packed TsRef : public IReg, IAddress<0x058C, size_t(BYTE)>
		{
			uint8_t result;
		};

		template<size_t T>
		concept IsGpioChannel = T >= 1 and T <= 8;

		template<Byte BYTE, size_t CHANNEL> requires IsGpioChannel<CHANNEL> and IsByte<BYTE>
		struct __packed Gpio : public IReg
		{
			uint8_t result;
		};

		template<Byte B> requires IsByte<B>
		struct __packed DieTemp1 : public IReg
		{
			uint8_t result;
		};

		template<Byte B> requires IsByte<B>
		struct __packed DieTemp2 : public IReg
		{
			uint8_t result;
		};

		template<Byte B> requires IsByte<B>
		struct __packed AuxCell : public IReg
		{
			uint8_t result;
		};

		template<Byte B> requires IsByte<B>
		struct __packed AuxGpio : public IReg
		{
			uint8_t result;
		};

		template<Byte B> requires IsByte<B>
		struct __packed AuxBat : public IReg
		{
			uint8_t result;
		};

		template<Byte B> requires IsByte<B>
		struct __packed AuxRefl : public IReg
		{
			uint8_t result;
		};

		template<Byte B> requires IsByte<B>
		struct __packed AuxVbg2 : public IReg
		{
			uint8_t result;
		};

		template<Byte B> requires IsByte<B>
		struct __packed AuxAvaoRef : public IReg
		{
			uint8_t result;
		};

		template<Byte B> requires IsByte<B>
		struct __packed AuxAvddRef : public IReg
		{
			uint8_t result;
		};

		template<Byte B> requires IsByte<B>
		struct __packed AuxOVDac : public IReg
		{
			uint8_t result;
		};

		template<Byte B> requires IsByte<B>
		struct __packed AuxUVDac : public IReg
		{
			uint8_t result;
		};

		template<Byte B> requires IsByte<B>
		struct __packed AuxOTCBDac : public IReg
		{
			uint8_t result;
		};

		template<Byte B> requires IsByte<B>
		struct __packed AuxUTDac : public IReg
		{
			uint8_t result;
		};

		template<Byte B> requires IsByte<B>
		struct __packed AuxVCBdoneDac : public IReg
		{
			uint8_t result;
		};

		template<Byte B> requires IsByte<B>
		struct __packed RefOVDac : public IReg
		{
			uint8_t result;
		};

		template<Byte B> requires IsByte<B>
		struct __packed DiagMain : public IReg
		{
			uint8_t result;
		};

		template<Byte B> requires IsByte<B>
		struct __packed DiagHi : public IReg
		{
			uint8_t result;
		};

		template<size_t CellChannel> requires IsCellChannel<CellChannel>
		struct __packed CBCellCtrl : public IReg
		{
			uint8_t undef;
		};

		struct __packed VMBDoneThresh : public IReg
		{
			uint8_t undef;
		};

		struct __packed MBTimerCtrl : public IReg
		{
			uint8_t undef;
		};

		struct __packed CBDoneThresh : public IReg
		{
			uint8_t undef;
		};

		struct __packed OTCBThresh : public IReg
		{
			uint8_t undef;
		};

		struct __packed BalCtrl1 : public IReg
		{
			uint8_t undef;
		};

		struct __packed BalCtrl2 : public IReg
		{
			uint8_t undef;
		};

		struct __packed BalCtrl3 : public IReg
		{
			uint8_t undef;
		};

		struct __packed CBComplete1 : public IReg
		{
			bool cell9_done : 1 { 0b0 };
			bool cell10_done : 1 { 0b0 };
			bool cell11_done : 1 { 0b0 };
			bool cell12_done : 1 { 0b0 };
			bool cell13_done : 1 { 0b0 };
			bool cell14_done : 1 { 0b0 };
			bool cell15_done : 1 { 0b0 };
			bool cell16_done : 1 { 0b0 };
		};

		struct __packed CBComplete2 : public IReg
		{
			bool cell1_done : 1 { 0b0 };
			bool cell2_done : 1 { 0b0 };
			bool cell3_done : 1 { 0b0 };
			bool cell4_done : 1 { 0b0 };
			bool cell5_done : 1 { 0b0 };
			bool cell6_done : 1 { 0b0 };
			bool cell7_done : 1 { 0b0 };
			bool cell8_done : 1 { 0b0 };
		};

		struct __packed BalTime : public IReg
		{
			uint8_t undef;
		};

		struct __packed OVThresh : public IReg
		{
			uint8_t undef;
		};
	}

	class Bq79616
	{
	private:
		template<typename T> requires Utils::IsReg<T>
		uint32_t constexpr constructWrite()
		{
			return 0;
		}

		template<typename T> requires Utils::IsReg<T>
		uint32_t constexpr constructRead()
		{
			return 0;
		}

		SPI_HandleTypeDef *hspi;

		static inline constexpr size_t size = 6;
		std::array<uint32_t, size> out { 0 };
		std::array<uint32_t, size> in { 0 };

	public:
		explicit Bq79616(SPI_HandleTypeDef *hspi) : hspi(hspi) { }

		void init()
		{

		}

		void wakeThatBitchUp()
		{

		}
	};


}

#endif /* INC_BQ79616_HPP_ */
