PUT-Motorsport/PUTM_EV_AMS_MASTER/(commit log)

2025-02-20 adc communication established, some data is aquired, needs further testing
2025-02-23 added a script which modifies hal spi libs - project builds
2025-03-09 changing bq79600 com from spi to uart in progress
2025-03-10 changed from spi to uart for bq79600 comm will need to change to code to
2025-03-11 change for bq to uart is done? time to test, but first need to end the read fn
2025-03-11 uart version testing in progress
2025-03-12 not working, implemented send works (verified), but issues with read?????? idk man
    [PUTM_EV_AMS_MASTER_2025.ioc, bq796xx.hpp]
2025-03-29 not working usb version
    [PUTM_EV_AMS_MASTER_2025.ioc, ads131m04.hpp, main.c]
2025-03-29 st usb device removed
2025-03-29 kicad auto save & lck remove
2025-04-01 migration to threadx + usbx, tested ads131m04, bq796xx yet to be tested, new project structure, itd
2025-04-01 Added Arduino json
2025-04-04 threadx done, usbx kinda (not) working
2025-04-12 error codes in progress
    [error_checker.cpp]
2025-04-17 errors done? still in testing adding bq temps
    [PUTM_EV_AMS_MASTER_2025.ioc, ads131m04.hpp, ads131m04_thread.cpp, air_state_machine.cpp, bq796xx.hpp, bq796xx_thread.cpp, error_checker.cpp]
2025-07-11 working new bq lib and uart wrapper
2025-07-20 still needs a few tweeks, there was sth wrong with the temp measurement gotta check that
    [PUTM_EV_AMS_MASTER_2025.ioc, ads131m04_thread.cpp, bq796xx.hpp, bq796xx_thread.cpp, com_thread.cpp]
2025-09-27 fix: added go to shutdown command for Bbq79616, in hopes that they will go to shutdown and draw only ~28uA
    [ads131m04.cpp, bq796xx.hpp, bq796xx_thread.cpp, com_thread.cpp, init.cpp]
2026-06-29 can fix, added tx/rx loop compensation and tweaked the can config
    [PUTM_EV_AMS_MASTER_2025.ioc, com_thread.cpp, error_checker.cpp, init.cpp]
2026-07-09 some improvements, uart still sometimes misses rx
2026-07-29 fsb update, tweaked some functionalities, added different strategies for temperature error detection, and tweaked the polynomial of voltage to temperature to grow thrice as slow after passing 40 degC
    [ads131m04.cpp, ads131m04_thread.cpp, air_state_machine.cpp, bq796xx_thread.cpp, charger_state_machine.cpp, com_thread.cpp]
2026-08-15 fix: temperature not throwing errors
    [com_thread.cpp, error_checker.cpp, soc.hpp]
2026-08-19 change segment, change thermistor map
2026-09-05 update minimum current threshold
2026-10-07 fix soc data sent to CAN
    [com_thread.cpp]
