PUT-Motorsport/PUTM_EV_AMS_MASTER/(notices)

Notices in the files:
firmware/Core/Inc/main.h:
Copyright (c) 2025 STMicroelectronics.
All rights reserved.
This software is licensed under terms that can be found in the LICENSE file
